willemet-remy/minidisk_automation/Document/20280826_Manuscript minidisk.docx

Experimental paper

Wireless time-of-flight sensor for water level monitoring: Infiltrometer case study

Rémy Willemet1,2*, Maarten Garmyn, Wim M. Cornelis²

¹Plant Sciences Unit, Flanders Research Institute for Agriculture, Fisheries and Food (ILVO), 9090 Merelbeke-Melle, Belgium

²Department of Environment – SENSE Unit, Ghent University, 9000 Ghent, Belgium

³Mississippi Water Resources Research Institute, Mississippi State University, Mississippi State, MS 39762, USA

*Corresponding author: remy.willemet@ilvo.vlaanderen.be

Targeted Journal:

# Abstract

# Introduction

Infiltration is important

Long to take measurements

Dream is costless, wireless, high frequency

3D print, AI helps develop

We can do simple solutions for measurements that

# Material & Method

Components 3D printer

GitHub explanation

Material needed

# Results & Discussion

Cost List + Figure

Part sensor | Cost (per unit) | Units | Provider
Esp 32 mini C3 | | 9
Vl53l4cd | | 8
TP4056 (Battery Chargin module) | | 8
Lipo battery | | 8
Battery holder plastic case | | 8
Buzzer | | 8
Switch/Button | | 16
O-ring rubber
Stainless screw M2

Part infiltrometer
PETG filament | | 1
Acrylic Tubes 26mm ID 32mm OD | | 8
Acrylic Tubes
Valve 32 mm
Stainless + Rubber | | | Meter group
O-ring rubber
Waterproof glue (Parabond) | 13.13 | 1
Stainless 5mm OD 4mm ID

Frequency

Connectivity

Esp32 takes a large place in automation as it’s a cost-effective, high-frequency device with its own communication system and sensors.

Conductivity

Outcomes for every water level device

# Conclusion
