willemet-remy/minidisk_automation/Data sheets/Screenshot 2026-02-20 092105.png

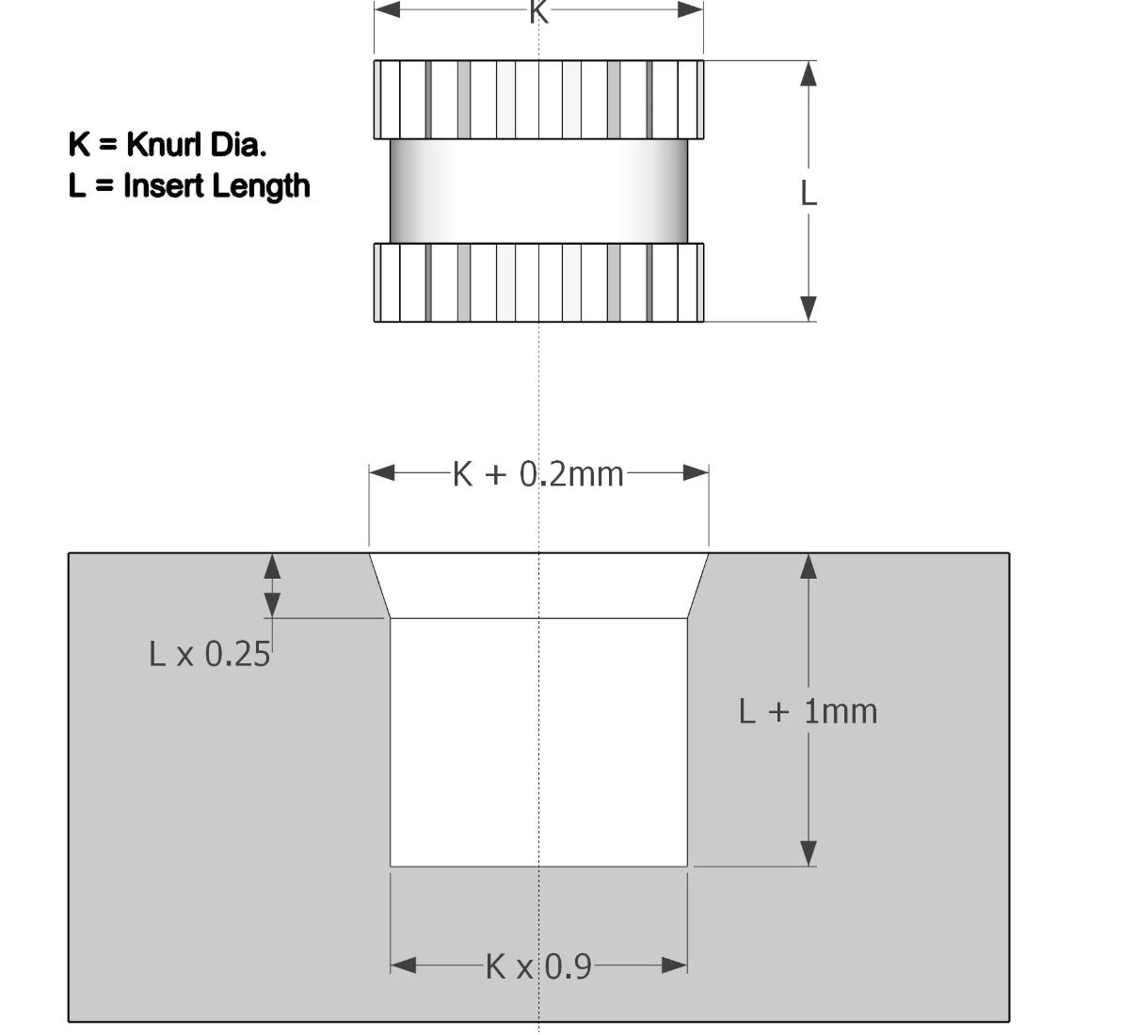
Data sheets/Screenshot 2026-02-20 092105.png
