willemet-remy/minidisk_automation/Figures/IMG_9297.jpg

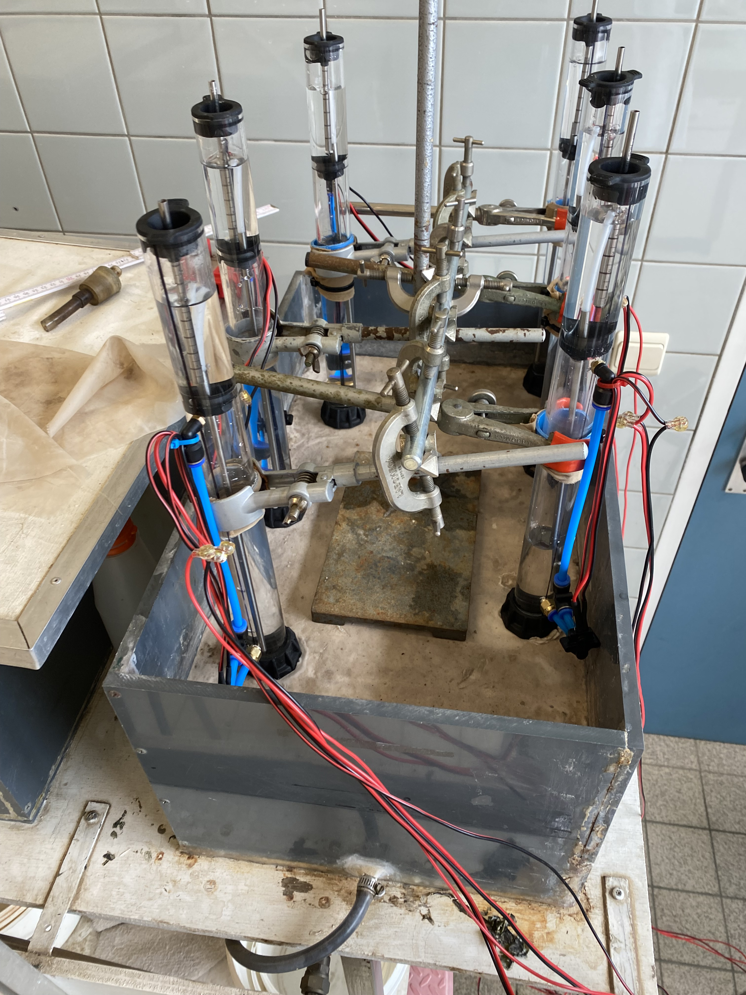
Figures/IMG_9297.jpg
