willemet-remy/minidisk_automation/Figures/IMG_9298.jpg

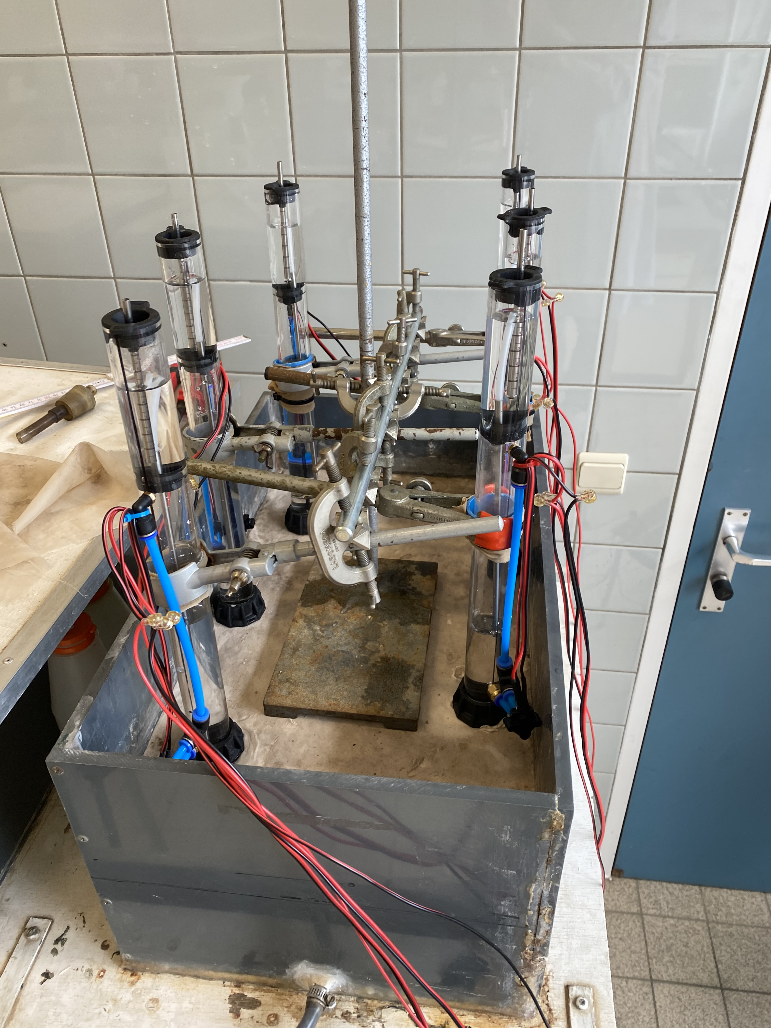
Figures/IMG_9298.jpg
