willemet-remy/minidisk_automation/Figures/IMG_9366.jpg

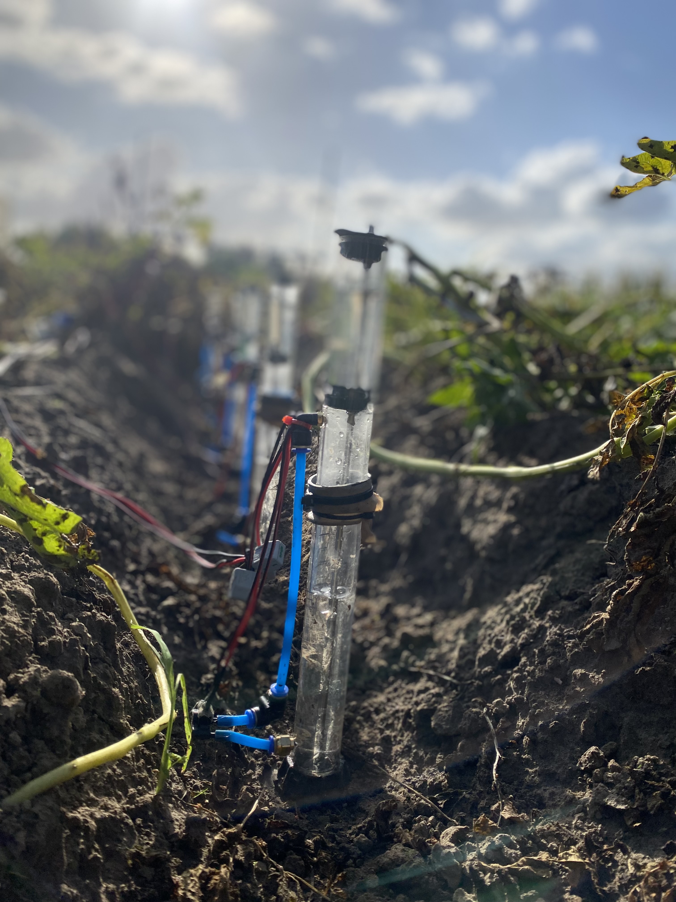
Figures/IMG_9366.jpg
