willemet-remy/minidisk_automation/Figures/IMG_9367.jpg

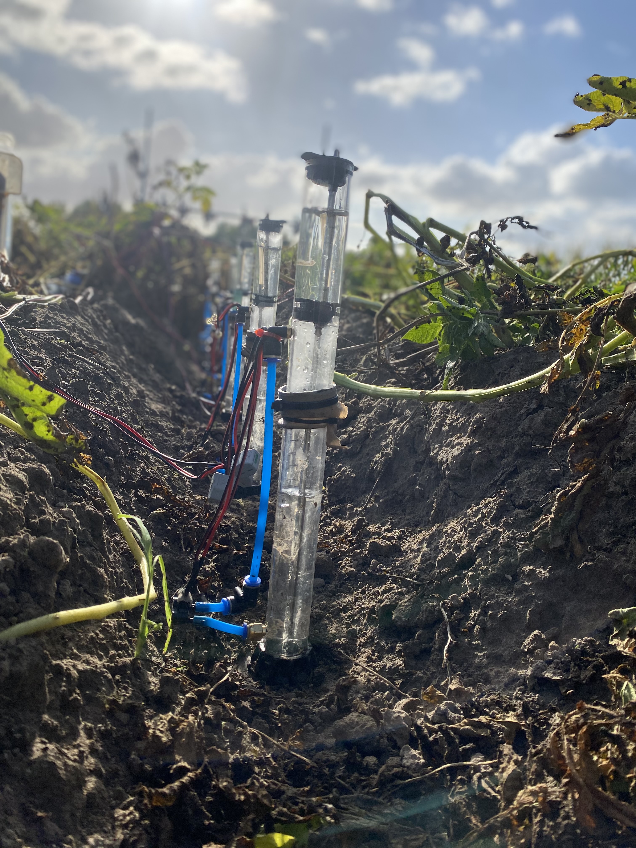
Figures/IMG_9367.jpg
