willemet-remy/minidisk_automation/Figures/IMG_9368.jpg

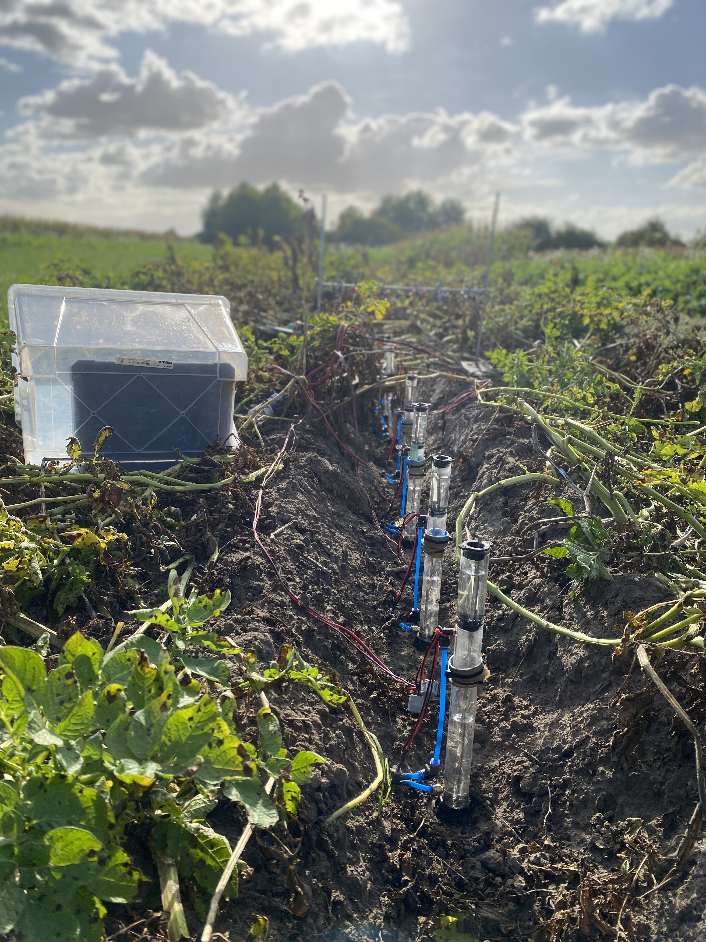
Figures/IMG_9368.jpg
