willemet-remy/minidisk_automation/Figures/IMG_9370.jpg

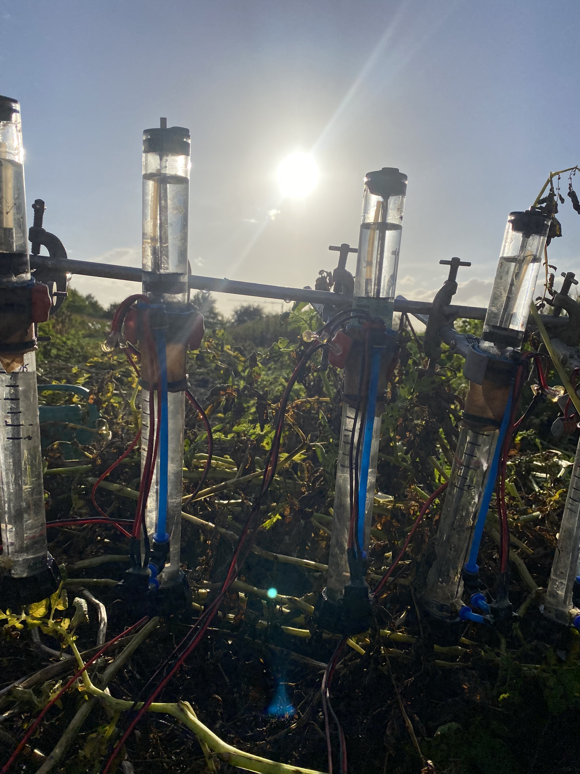
Figures/IMG_9370.jpg
