willemet-remy/minidisk_automation/Figures/IMG_9520.jpg

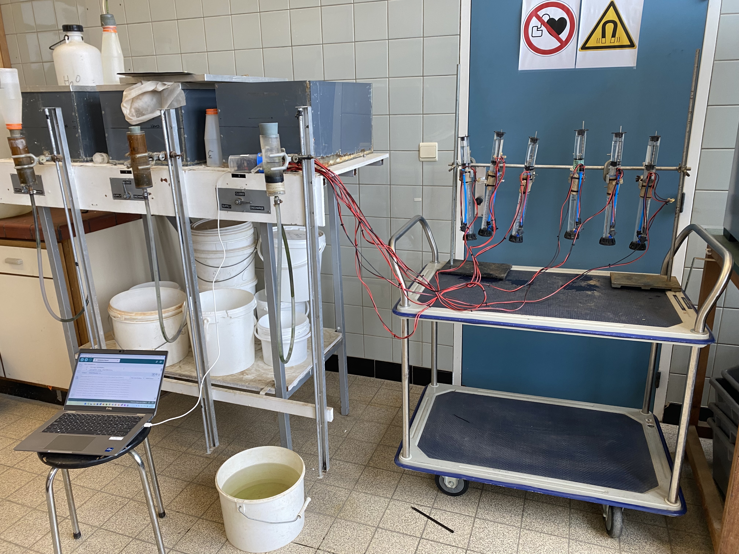
Figures/IMG_9520.jpg
