willemet-remy/minidisk_automation/Figures/IMG_9521.jpg

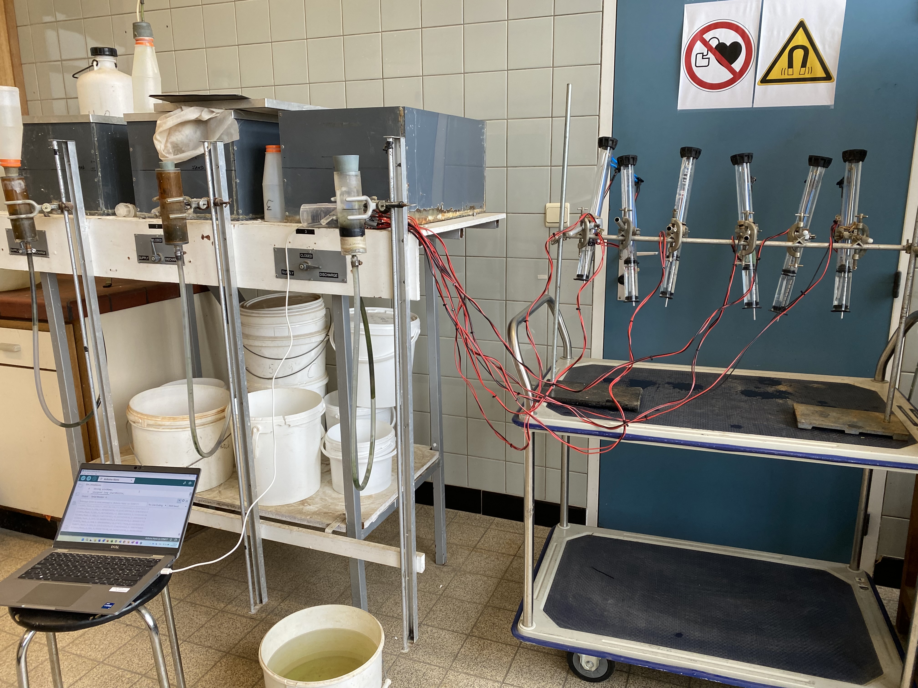
Figures/IMG_9521.jpg
