willemet-remy/minidisk_automation/Figures/IMG_9550.jpg

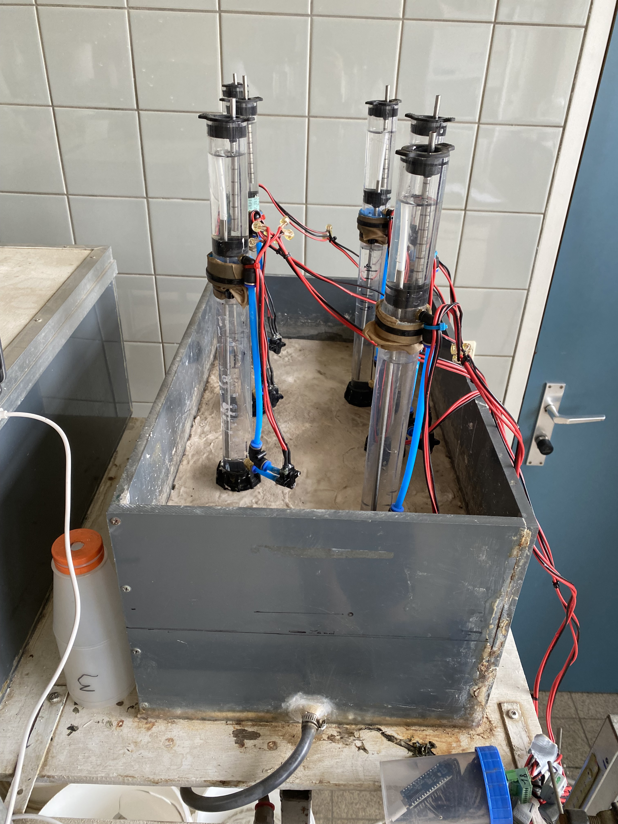
Figures/IMG_9550.jpg
