willemet-remy/minidisk_automation/Figures/IMG_9551.jpg

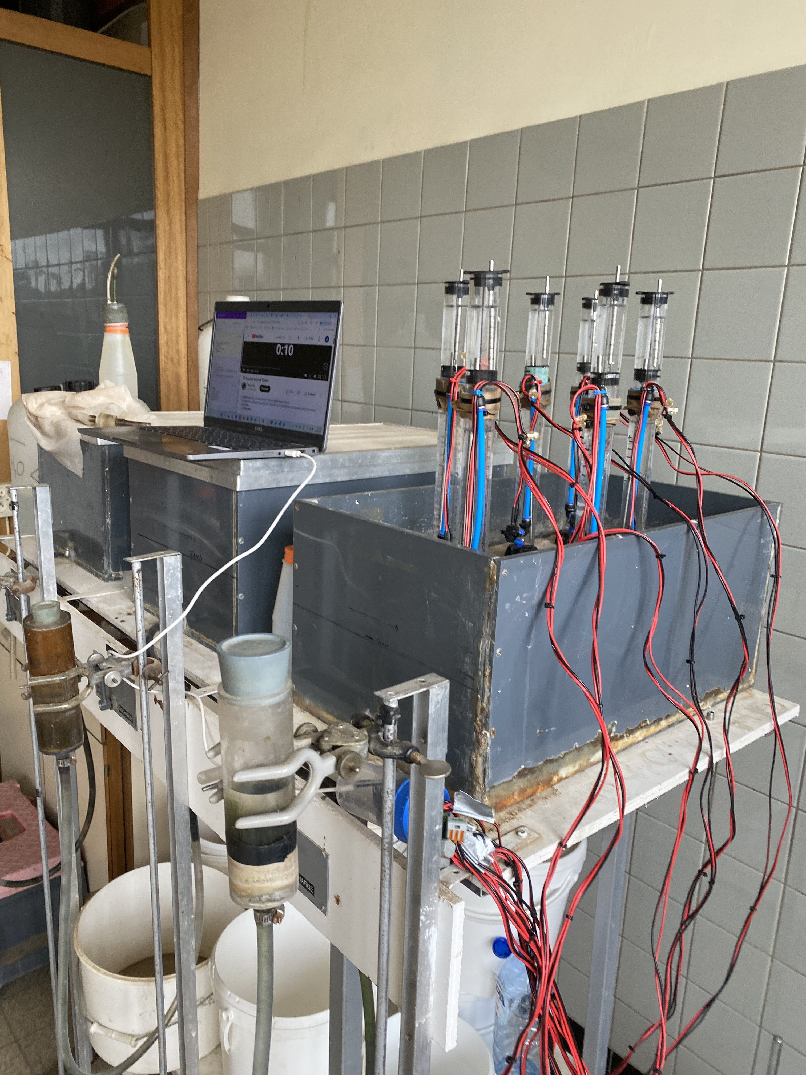
Figures/IMG_9551.jpg
