willemet-remy/minidisk_automation/Figures/Mariotte_Cylinder.gif

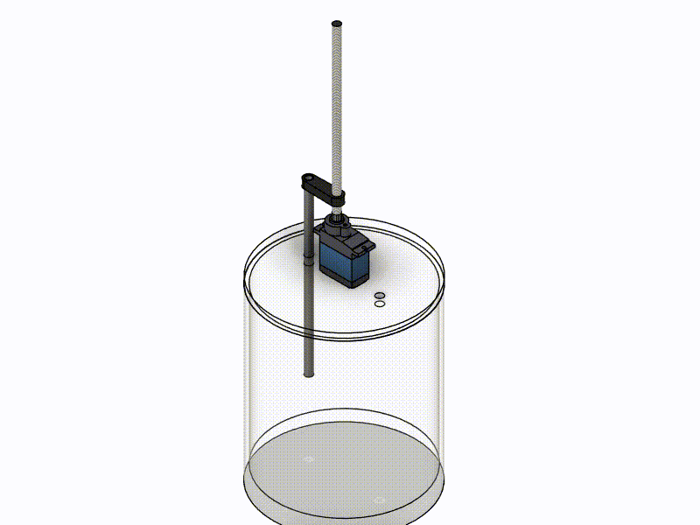
Figures/Mariotte_Cylinder.gif
