willemet-remy/minidisk_automation/PCB_microcontroller/Slimme_minidisk_BOM.xlsx

Component | Designation | Footprint | P/P | Minimal P order | Nbr piece necessary (10) | Piece ordered | Total | Fabrikan nummer | Link
Resistor - 10Kohm | R4,R5,R6,R7 | Resistor_SMD:R_0805_2012Metric_Pad1.20x1.40mm_HandSolder | 0.066 | 100 | 40.00 | 100.00 | 6.60 | ERJHP6F1002V | https://benl.rs-online.com/web/p/surface-mount-resistors/2284960
Resistor 2.7Kohm | R3 | Resistor_SMD:R_0805_2012Metric_Pad1.20x1.40mm_HandSolder | 0.072 | 10 | 10.00 | 10.00 | 0.72 | RT0805BRD072K7L | https://benl.rs-online.com/web/p/surface-mount-resistors/1985630
Resistor - 100ohm | R1,R2 | Resistor_SMD:R_0805_2012Metric_Pad1.20x1.40mm_HandSolder | 0.066 | 100 | 20 | 100 | 6.60 | ERJHP6F1000V | https://benl.rs-online.com/web/p/surface-mount-resistors/2284956
Led - Green | D1 | LED_SMD:LED_0805_2012Metric_Pad1.15x1.40mm_HandSolder | 0.451 | 10 | 10 | 10 | 4.51 | KP-2012MGC | https://benl.rs-online.com/web/p/leds/4663778
Led -Red | D2 | LED_SMD:LED_0805_2012Metric_Pad1.15x1.40mm_HandSolder | 0.224 | 20 | 10 | 20 | 4.48 | KP-2012SYC | https://benl.rs-online.com/web/p/leds/4663835
Cable - 6 brins |  |  | 1.318 |  |  | 25 | 32.95 | 201-2215 | https://benl.rs-online.com/web/p/twisted-pair-multicore-data-cable/2012215
VL53L4CD | U1 | Sensor_Distance:ST_VL53L1x | 3.04 | 1 | 10 | 10 | 30.40 | VL53L4CDV9DH/1 | https://benl.rs-online.com/web/p/proximity-sensor-ics/0215169
MCP23017 |  |  | 1.476 | 5 |  |  |  | MCP23017-E/SP | https://benl.rs-online.com/web/p/io-expanders/0403806
Capacitor - 4.7µF | C1 | Capacitor_SMD:C_0805_2012Metric_Pad1.18x1.45mm_HandSolder | 0.11 | 10 | 10 | 10 | 1.10 | GRT21BR61H475KE13L | https://benl.rs-online.com/web/p/mlccs-multilayer-ceramic-capacitors/2478211
Capacitor - 0.1 µF | C2 | Capacitor_SMD:C_0805_2012Metric_Pad1.18x1.45mm_HandSolder | 0.105 | 100 | 10 | 100 | 10.50 | GCJ21BR72A104KA01K | https://benl.rs-online.com/web/p/mlccs-multilayer-ceramic-capacitors/2608714
BC817W | Q1 | Package_TO_SOT_SMD:SOT-323_SC-70
DevkitC
PCB
Rubber |  |  | 5.99 | 1 | 1 | 1 | 5.99 | 196-5426 | https://benl.rs-online.com/web/p/gaskets-o-rings/1965426
Solder paste |  |  | 14.27 | 1 | 1 | 1 | 14.27 | SMD291AX50T3 | https://benl.rs-online.com/web/p/solder-pastes/1466191
Stepper motor |  |  |  |  |  |  |  |  | https://benl.rs-online.com/web/p/power-motor-robotics-development-tools/1793741
Mesh
