willemet-remy/minidisk_automation/PCB_microcontroller/PCB_sensor_V4/BOM_PCB_V4.csv

Reference | Qty | Value | DNP | Exclude from BOM | Exclude from Board | Footprint | Datasheet
C1 | 1 | 0.1µF |  |  |  | Capacitor_SMD:C_0805_2012Metric_Pad1.18x1.45mm_HandSolder | ~
C2 | 1 | 4.7µF |  |  |  | Capacitor_SMD:C_0805_2012Metric_Pad1.18x1.45mm_HandSolder | ~
D1 | 1 | LED RED |  |  |  | LED_SMD:LED_0805_2012Metric_Pad1.15x1.40mm_HandSolder | ~
D2 | 1 | LED Green |  |  |  | LED_SMD:LED_0805_2012Metric_Pad1.15x1.40mm_HandSolder | ~
H1 | 1 | SCL |  | Excluded from BOM |  | TestPoint:TestPoint_Pad_1.5x1.5mm | ~
H2 | 1 | SDA |  | Excluded from BOM |  | TestPoint:TestPoint_Pad_D1.5mm | ~
H3 | 1 | GPI0 |  | Excluded from BOM |  | TestPoint:TestPoint_Pad_D1.5mm | ~
H4 | 1 | XSHUT |  | Excluded from BOM |  | TestPoint:TestPoint_Pad_D1.5mm | ~
H5 | 1 | 3V3 |  | Excluded from BOM |  | TestPoint:TestPoint_Pad_D1.5mm | ~
H6 | 1 | GND |  | Excluded from BOM |  | TestPoint:TestPoint_Pad_D1.5mm | ~
H7 | 1 | MountingHole_Pad |  | Excluded from BOM |  | Growing_chamber:MountingHole_5mm_modif | ~
Q1 | 1 | BC817W |  |  |  | Package_TO_SOT_SMD:SOT-323_SC-70 | https://www.onsemi.com/pub/Collateral/BC818-D.pdf
R1,R2 | 2 | 100 |  |  |  | Resistor_SMD:R_0805_2012Metric_Pad1.20x1.40mm_HandSolder | ~
R3 | 1 | 2.7K |  |  |  | Resistor_SMD:R_0805_2012Metric_Pad1.20x1.40mm_HandSolder | ~
R4 | 1 | 10KΩ |  |  |  | Resistor_SMD:R_0805_2012Metric_Pad1.20x1.40mm_HandSolder | ~
R5,R6,R7 | 3 | 10K |  |  |  | Resistor_SMD:R_0805_2012Metric_Pad1.20x1.40mm_HandSolder | ~
U1 | 1 | VL53L0CXV0DH1 |  |  |  | Sensor_Distance:ST_VL53L1x | https://www.st.com/resource/en/datasheet/vl53l0x.pdf
