willemet-remy/minidisk_automation/Model/3D_print/case_nodemcu_esp32_s_sma_antenna_mount_bottom.3mf

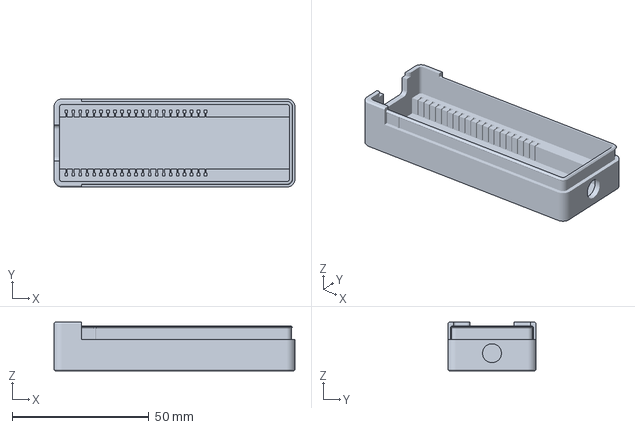
[picture p23: CAD file, 2026-10-27]
Model/3D_print/case_nodemcu_esp32_s_sma_antenna_mount_bottom.3mf
88.0 x 32.2 x 17.8 mm
