willemet-remy/minidisk_automation/Model/Fusion360/CapV3.3mf

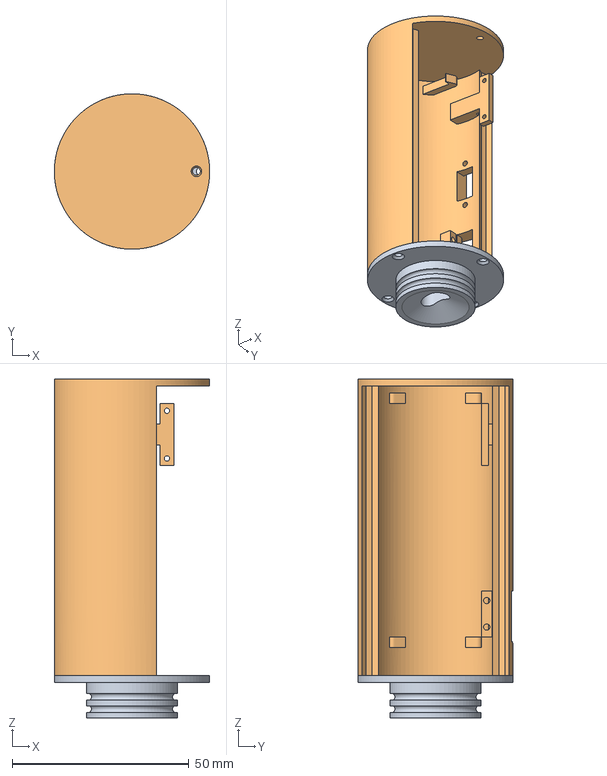
[picture p24: CAD file, 2026-09-15]
Model/Fusion360/CapV3.3mf
44.0 x 44.0 x 96.0 mm
