willemet-remy/minidisk_automation/Model/3D_print/case_nodemcu_esp32_s_sma_antenna_mount_top.3mf

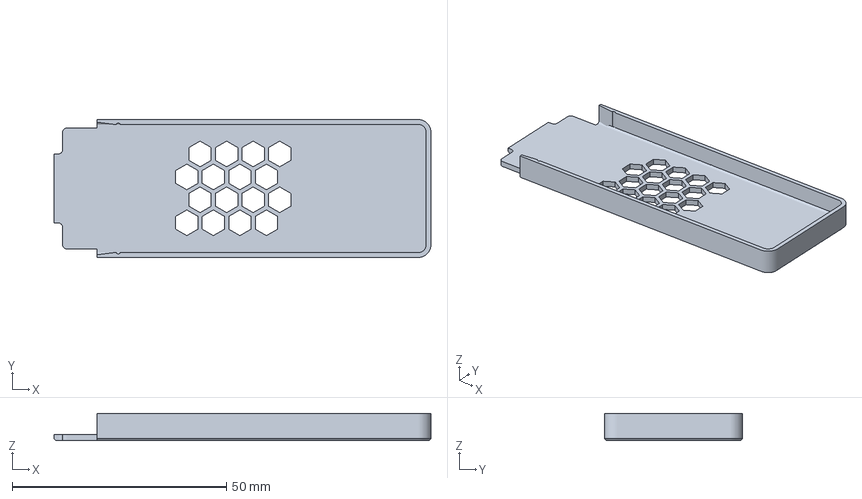
[picture p25: CAD file, 2026-10-27]
Model/3D_print/case_nodemcu_esp32_s_sma_antenna_mount_top.3mf
88.0 x 32.2 x 6.40 mm
