willemet-remy/minidisk_automation/Model/3D_print/Joint_tubes.stl

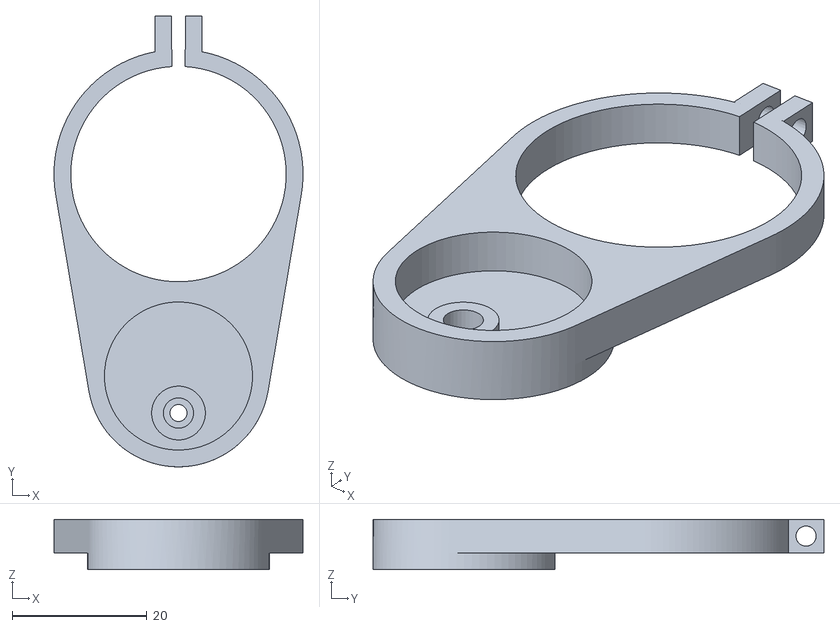
[picture p26: CAD file, 2026-09-15]
Model/3D_print/Joint_tubes.stl
37.0 x 67.0 x 7.50
