willemet-remy/minidisk_automation/Model/Fusion360/External_components/ss12d10.stp

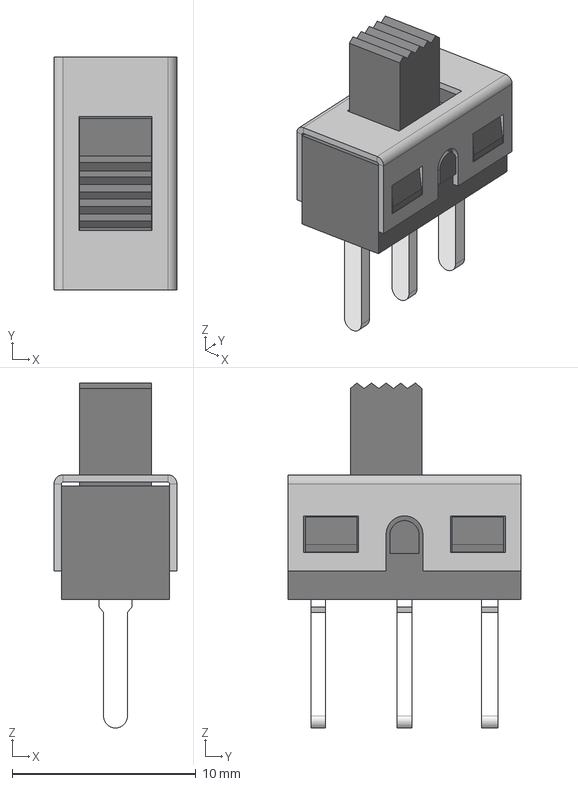
[picture p27: CAD file, 2026-09-15]
Model/Fusion360/External_components/ss12d10.stp
6.70 x 12.7 x 18.8 mm
