willemet-remy/minidisk_automation/Model/3D_print/Cap_bottom.stl

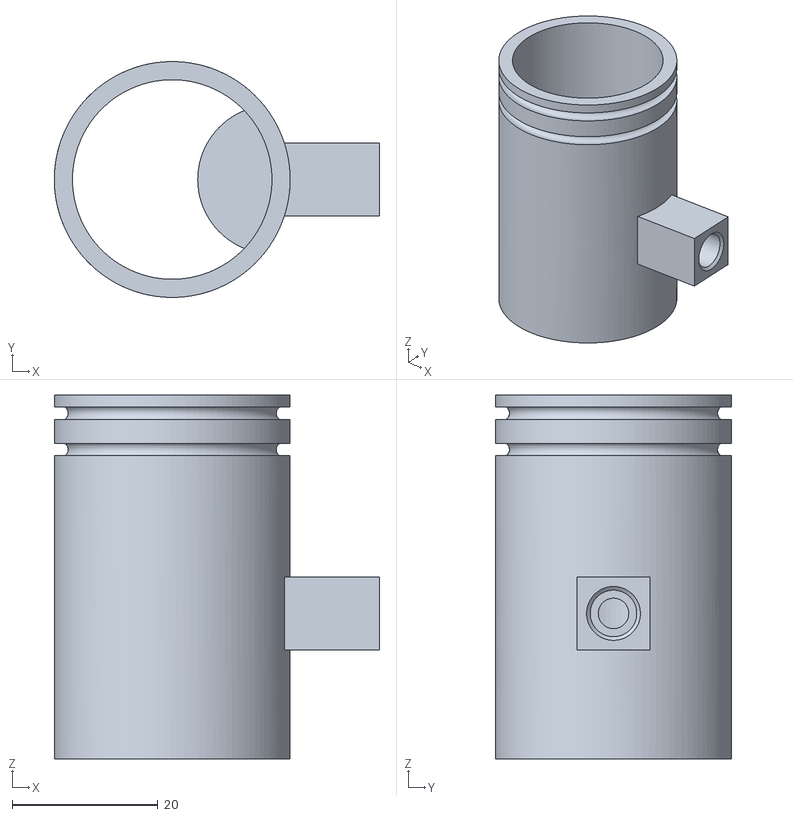
[picture p28: CAD file, 2026-09-15]
Model/3D_print/Cap_bottom.stl
44.7 x 32.4 x 50.0
