willemet-remy/minidisk_automation/Model/Fusion360/External_components/Esp32-C3_mini.STEP

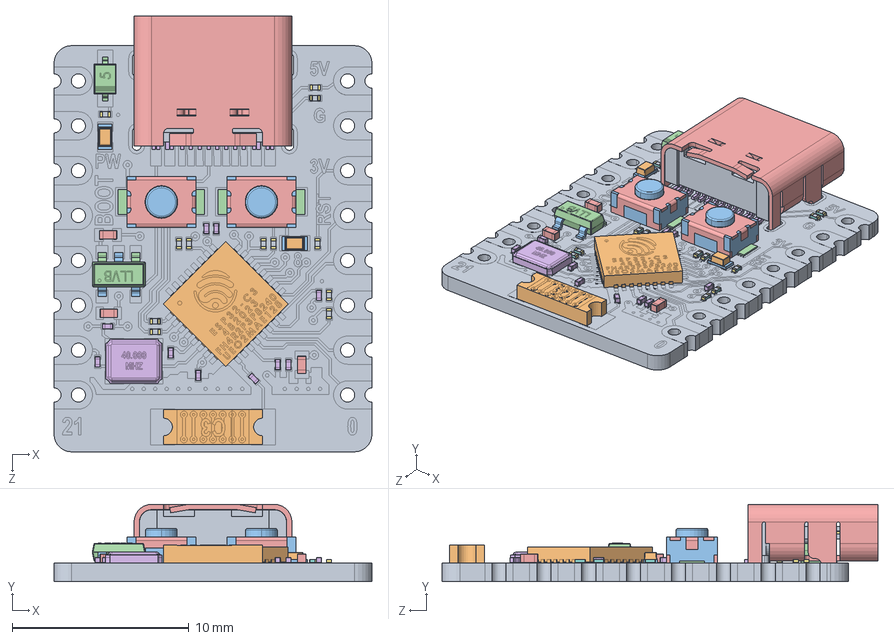
[picture p29: CAD file, 2026-09-15]
Model/Fusion360/External_components/Esp32-C3_mini.STEP
18.0 x 4.38 x 24.7 mm
PIEZASLDPRT
ESP82C3
LLVB
C0402 x 3
C0201 x 10
R0201 x 12
Led 0603 Smd x 2
SOD323 5
USB C female
Antenna_C3
SMD Micro Switch 3x4x2mm x 2
SMD Quartz Crystal 3.2x2.5mm
