willemet-remy/minidisk_automation/Model/3D_print/Cap_top_body1.stl

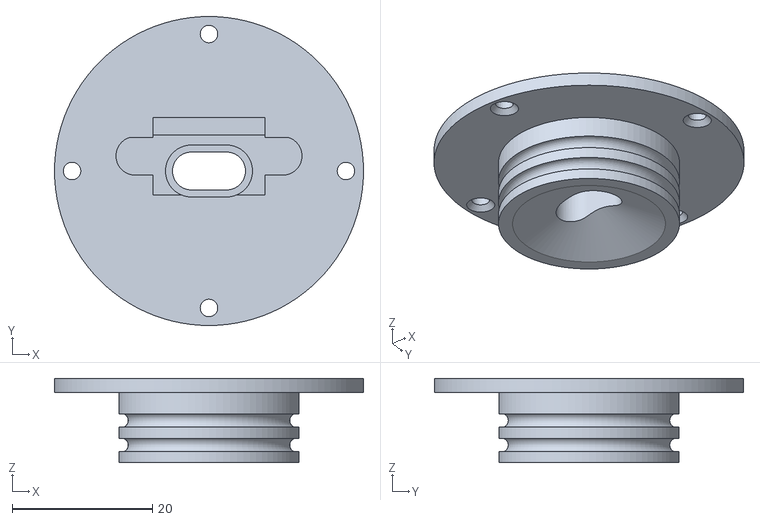
[picture p30: CAD file, 2026-09-10]
Model/3D_print/Cap_top_body1.stl
44.0 x 44.0 x 12.0
