willemet-remy/minidisk_automation/Model/Fusion360/External_components/Mini Slide Switch.step

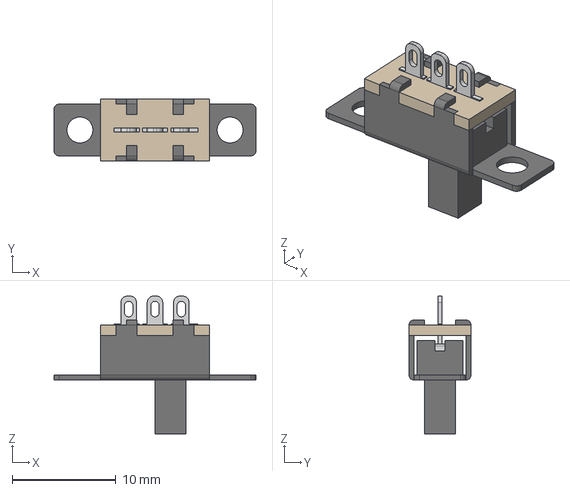
[picture p31: CAD file, 2026-09-15]
Model/Fusion360/External_components/Mini Slide Switch.step
19.5 x 6.00 x 13.3 mm
