willemet-remy/minidisk_automation/Model/3D_print/Cap_top_body2.stl

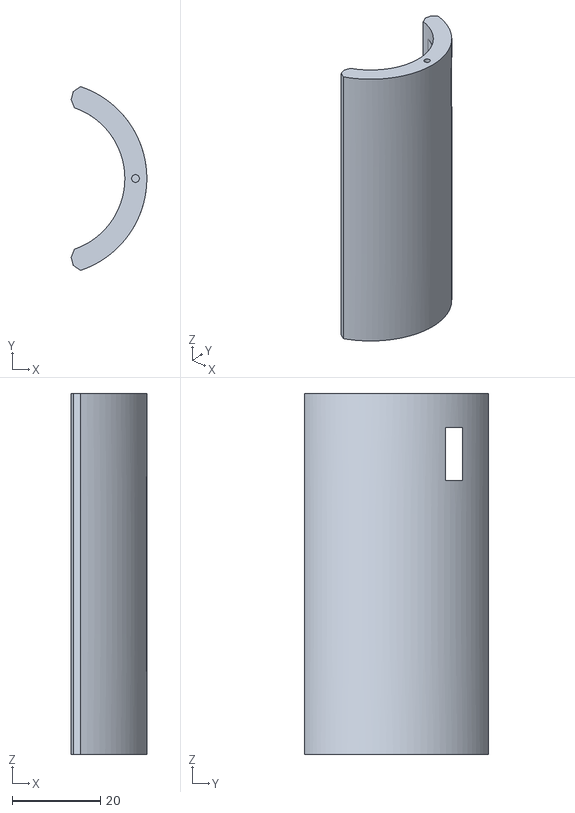
[picture p32: CAD file, 2026-09-10]
Model/3D_print/Cap_top_body2.stl
17.2 x 41.8 x 82.0
