willemet-remy/minidisk_automation/Model/Fusion360/External_components/Acrylic_Tube_small.stl

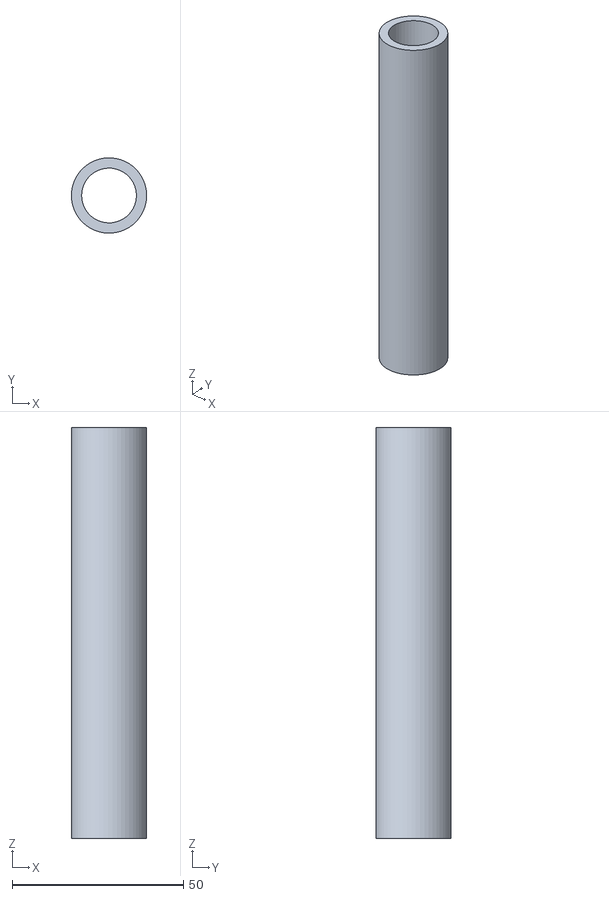
[picture p33: CAD file, 2026-09-15]
Model/Fusion360/External_components/Acrylic_Tube_small.stl
22.0 x 22.0 x 120.0
