willemet-remy/minidisk_automation/Model/Fusion360/External_components/MicroSwitch 2A SPDT CYT1073 3D.stl

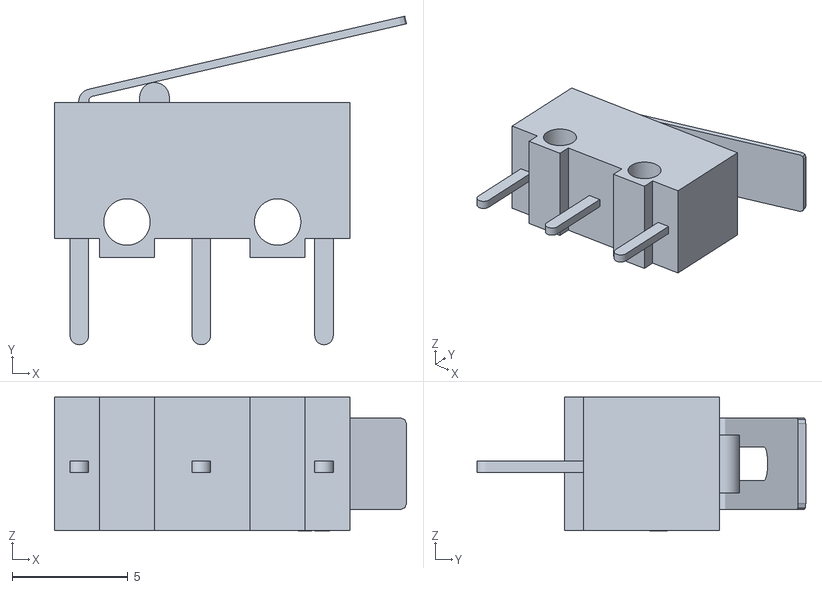
[picture p35: CAD file, 2026-09-15]
Model/Fusion360/External_components/MicroSwitch 2A SPDT CYT1073 3D.stl
15.2 x 14.2 x 5.77
