willemet-remy/minidisk_automation/Model/Fusion360/External_components/TP4056_Charging_Module_Type_C.step

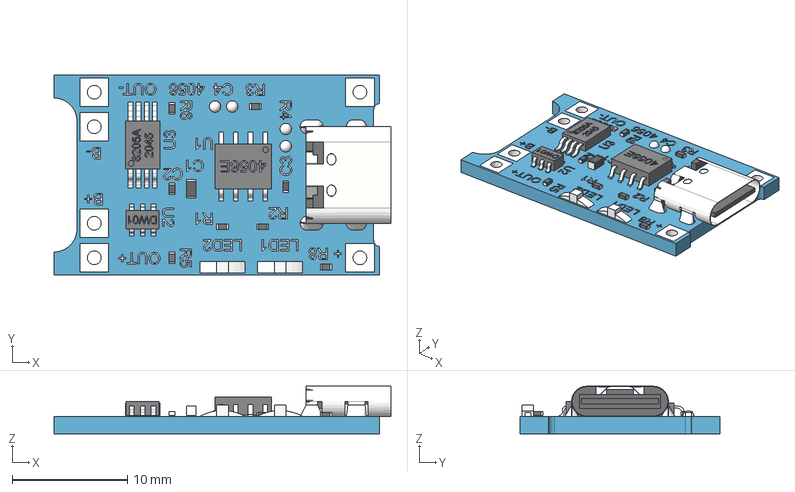
[picture p36: CAD file, 2026-09-15]
Model/Fusion360/External_components/TP4056_Charging_Module_Type_C.step
29.3 x 17.4 x 4.14 mm
board
USB_Type_C_Connector
8205A_2045
DW01-P
small1005_smd_resistor x 2
small1005_smd_resistor (1)
small1005_smd_capacitor
smd_capacitor
SOP-8_4056E
solder_dot_round
solder_dot_round (1)
solder_dot_round (2)
solder_dot_round (3)
small1005_smd_capacitor (1)
LED2
LED2 (1)
small1005_smd_resistor (2)
small1005_smd_resistor (4) x 2
soldering
