willemet-remy/minidisk_automation/Model/Fusion360/External_components/Acrylic Tube.stl

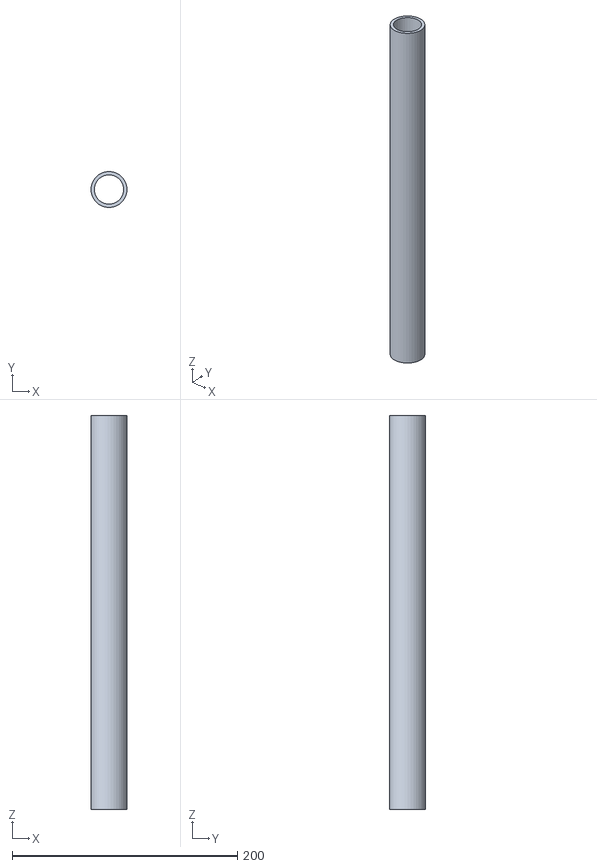
[picture p37: CAD file, 2026-09-15]
Model/Fusion360/External_components/Acrylic Tube.stl
32.0 x 31.9 x 350.0
