willemet-remy/minidisk_automation/Model/Fusion360/External_components/AH14629-A.stp

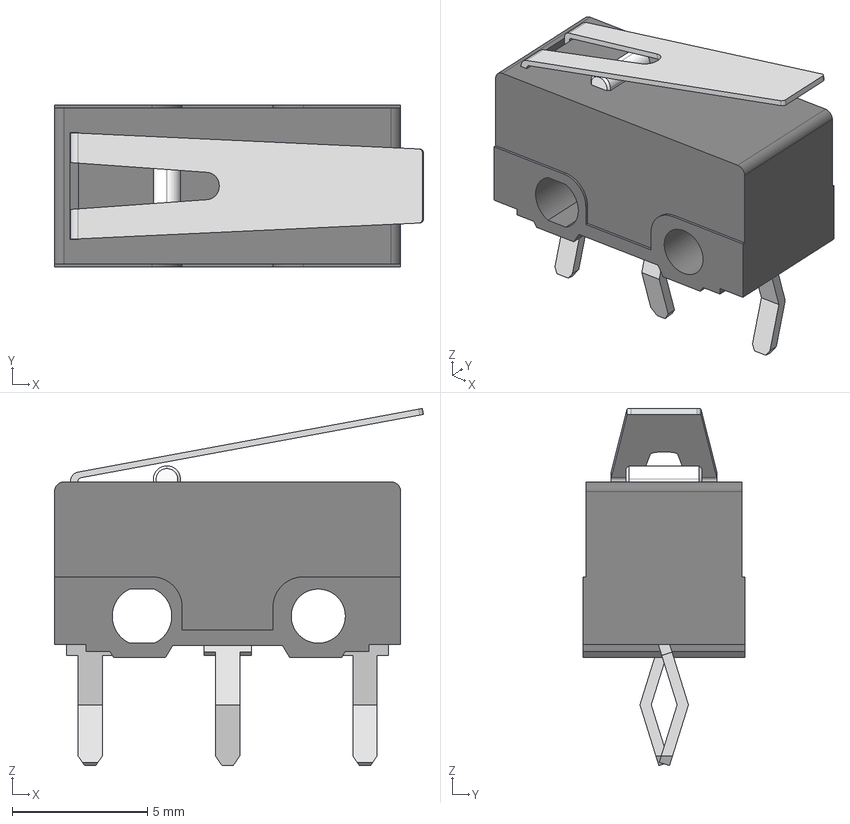
[picture p39: CAD file, 2026-09-15]
Model/Fusion360/External_components/AH14629-A.stp
13.6 x 6.00 x 13.2 mm
