willemet-remy/minidisk_automation/Model/Fusion360/External_components/18650 3.7V Battery Box Case with On Off Switch.STEP

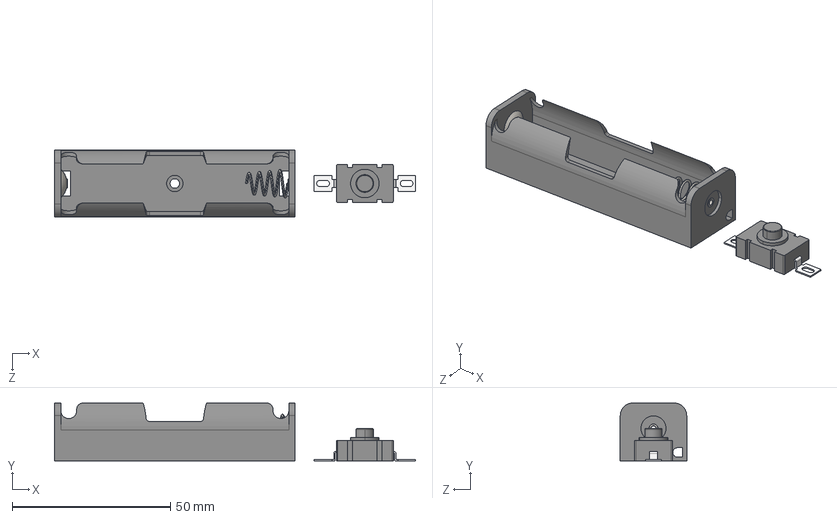
[picture p40: CAD file, 2026-09-15]
Model/Fusion360/External_components/18650 3.7V Battery Box Case with On Off Switch.STEP
114.0 x 18.3 x 21.0 mm
Case, 18650 3.7V Battery Box Case with On Off Switch
Battery Conduction Clip, Positive Terminal, 18650 3.7V Battery Box Case with On Off Switch
Battery Conduction Rivet, Negative Terminal, 18650 3.7V Battery Box Case with On Off Switch
Spring, 18650 3.7V Battery Box Case with On Off Switch
Push Button, 18650 3.7V Battery Box Case with On Off Switch
