willemet-remy/minidisk_automation/(list of files, cad)

Other CAD files:
Model/Fusion360/CapV3.f3d
Model/Fusion360/External_components/2772T93_NO THREADS_Straight Plastic On-Off Valve.stl
