willemet-remy/minidisk_automation/Figures/Sensor V2 Drawing.pdf

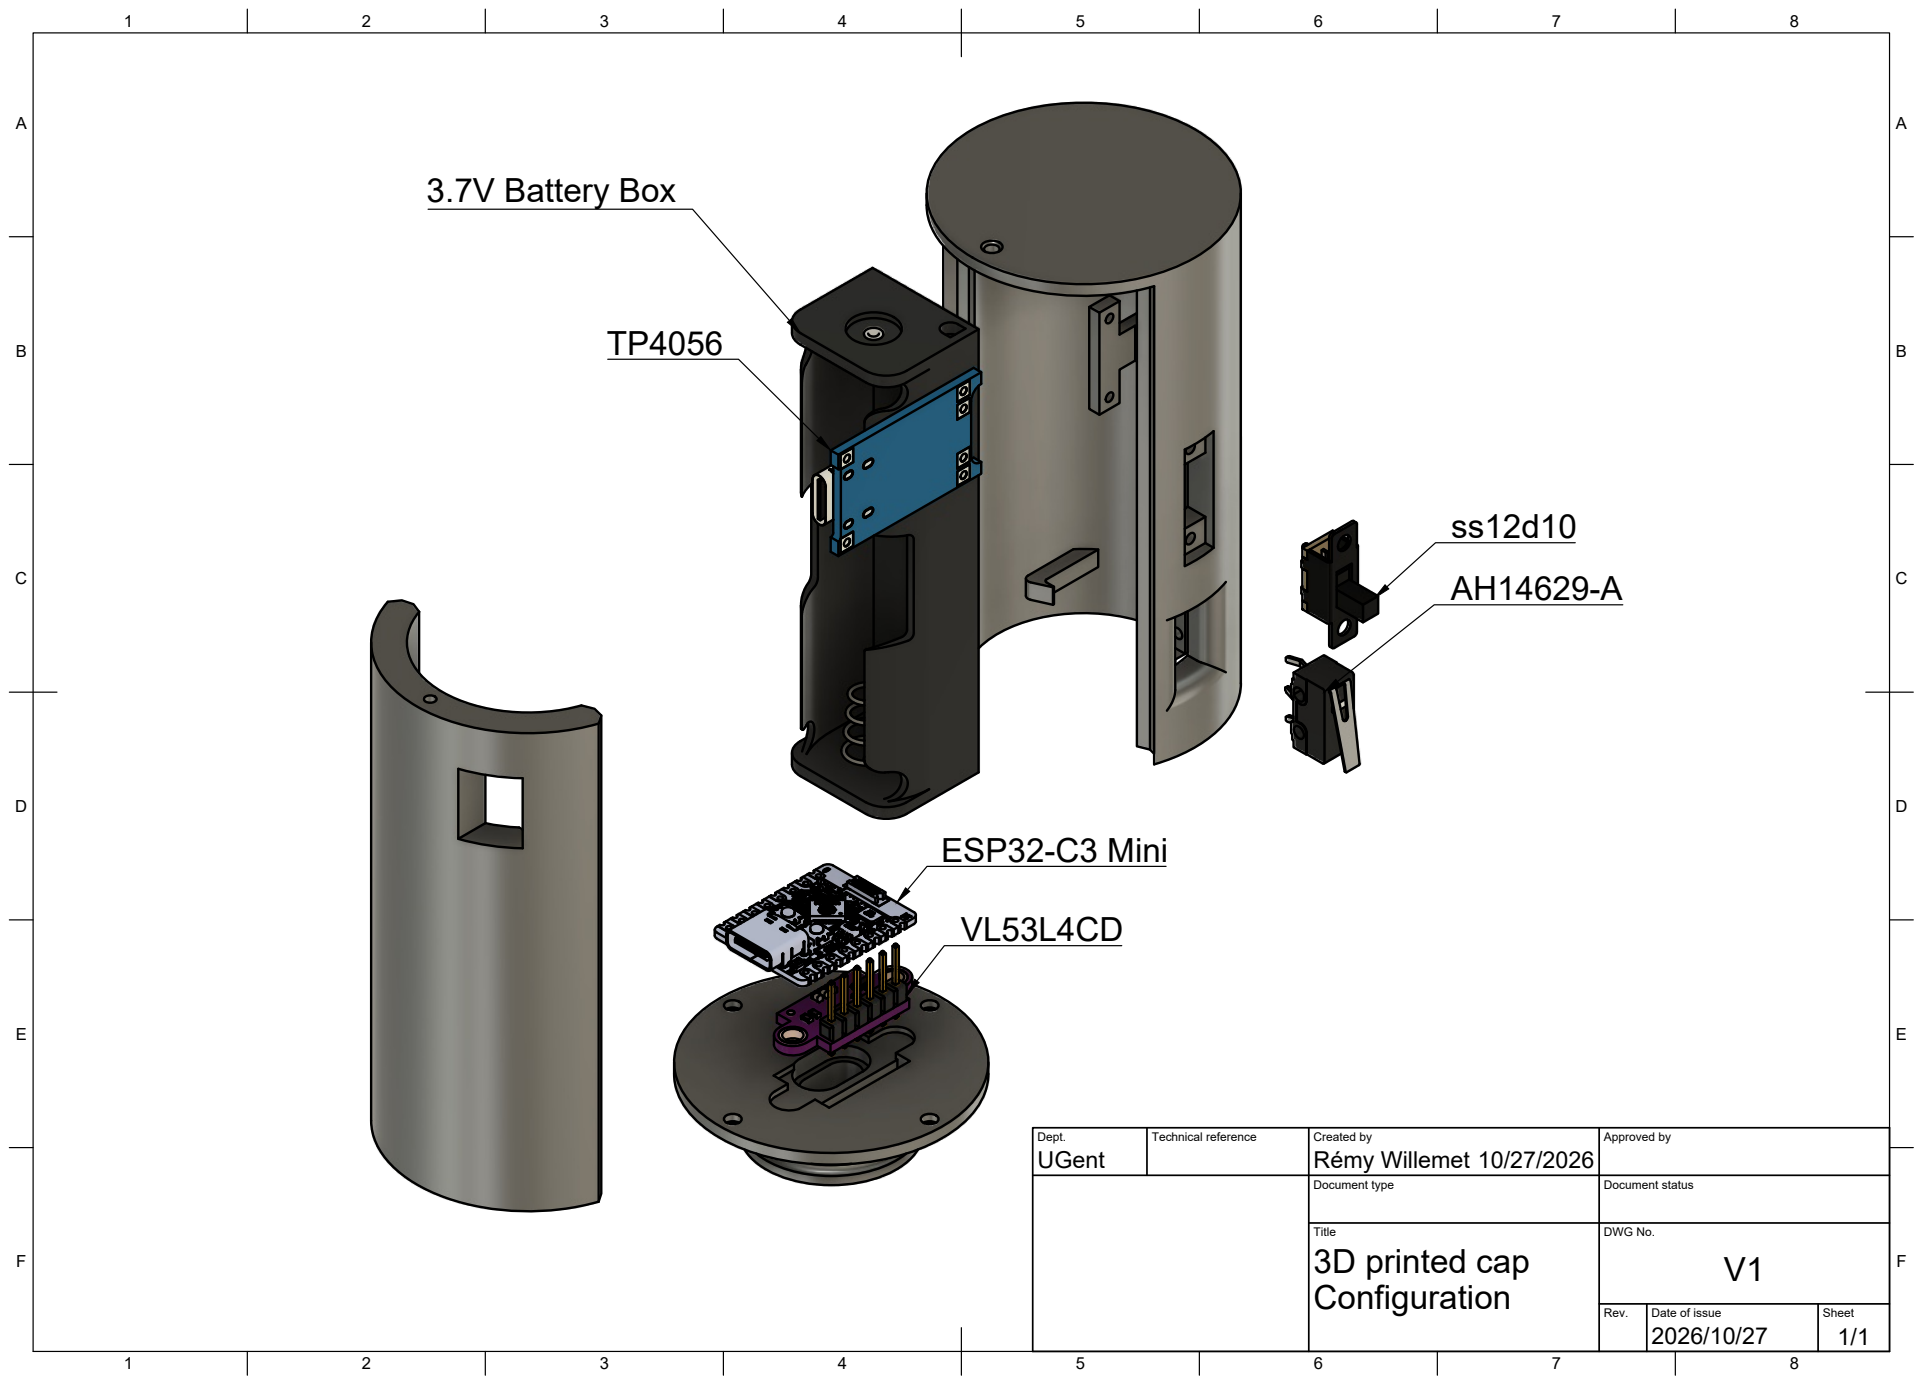
[picture p41: page 1]
Title; DWG No.; Rev.; Date of issue; Sheet; 3D printed cap; 3.7V Battery Box; ESP32-C3 Mini

Dept. UGent | Technical reference | Created by Rémy Willemet 10/27/2026 | Approved by

Document type | Document status
