willemet-remy/minidisk_automation/Figures/Slimme_minidisk_V1.pdf

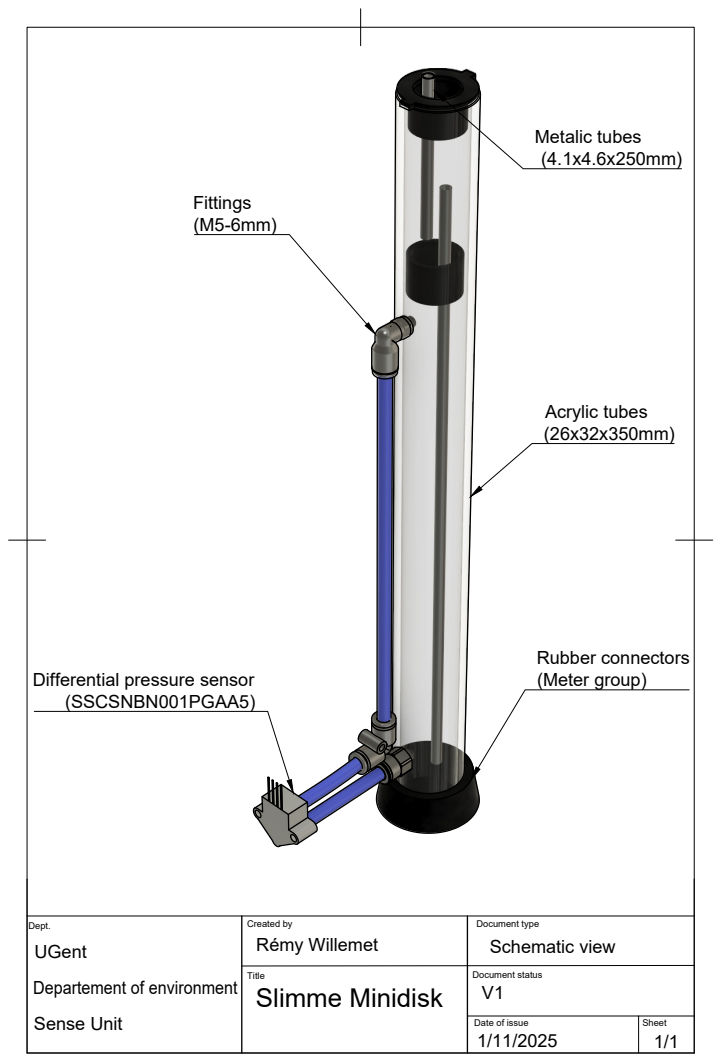
[picture p42: page 1]
Acrylic tubes; Metalic tubes; Rubber connectors; Differential pressure sensor; (Meter group)

Dept. UGent Departement of environment Sense Unit | Created by Rémy Willemet | Document type Schematic view

Title Slimme Minidisk | Document status V1

Date of issue 1/11/2025 | Sheet 1/1
