willemet-remy/minidisk_automation/PCB_microcontroller/PCB_sensor_V2/PCB_sensor.kicad_pcb

## KiCad design PCB_microcontroller/PCB_sensor_V2/PCB_sensor.kicad_pcb (2026-03-01, an earlier design)

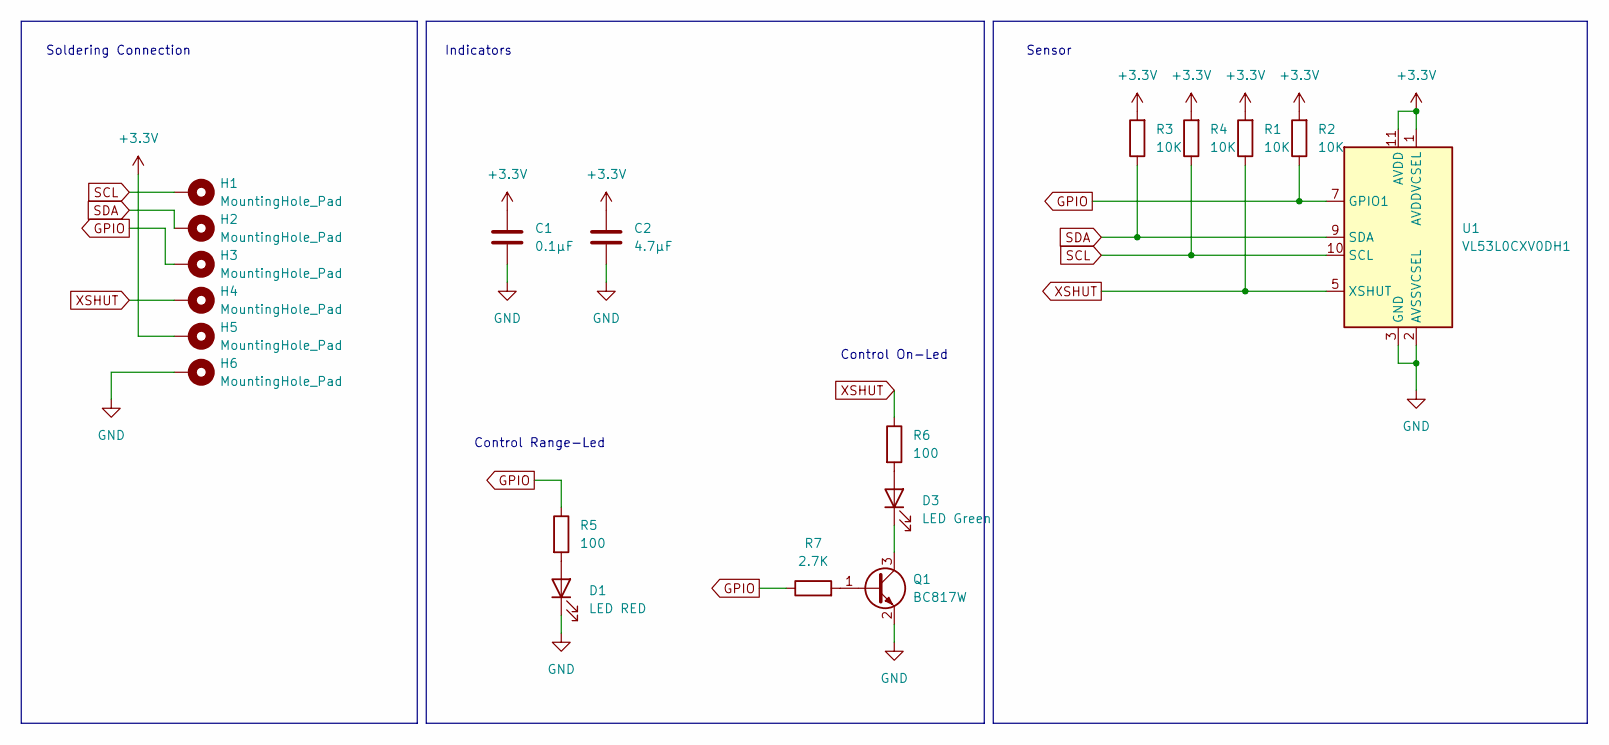
[picture p43: schematic PCB_sensor.kicad_sch]

Parts:
C1: 0.1µF; C_0201_0603Metric_Pad0.64x0.40mm_HandSolder
C2: 4.7µF; C_0201_0603Metric_Pad0.64x0.40mm_HandSolder
D1: LED RED; LED_0201_0603Metric_Pad0.64x0.40mm_HandSolder
D3: LED Green; LED_0201_0603Metric_Pad0.64x0.40mm_HandSolder
H1: MountingHole_Pad; TestPoint_Pad_1.5x1.5mm
H2, H3, H4, H5, H6: MountingHole_Pad; TestPoint_Pad_D1.5mm
Q1: BC817W; SOT-323_SC-70
R1, R2, R3, R4: 10K; R_0201_0603Metric_Pad0.64x0.40mm_HandSolder
R5, R6: 100; R_0201_0603Metric_Pad0.64x0.40mm_HandSolder
R7: 2.7K; R_0201_0603Metric_Pad0.64x0.40mm_HandSolder
U1: VL53L0CXV0DH1; ST_VL53L1x

Connections:
+3.3V: C1.1, C2.1, H5.1, R1.2, R2.2, R3.2, R4.2, U1.1 (AVDDVCSEL), U1.11 (AVDD)
GND: C1.2, C2.2, D1.1 (K), H6.1, Q1.2 (E), U1.2 (AVSSVCSEL), U1.3 (GND), U1.4 (GND), U1.6 (GND), U1.12 (GND)
GPIO: H3.1, R2.1, R5.1, R7.1, U1.7 (GPIO1)
unnamed: D1.2 (A), R5.2
unnamed: D3.2 (A), R6.2
unnamed: D3.1 (K), Q1.3 (C)
unnamed: Q1.1 (B), R7.2
SCL: H1.1, R4.1, U1.10 (SCL)
SDA: H2.1, R3.1, U1.9 (SDA)
XSHUT: H4.1, R1.1, R6.1, U1.5 (XSHUT)

Notes on the sheet:
Indicators
Control On-Led
Sensor
Soldering Connection
Control Range-Led

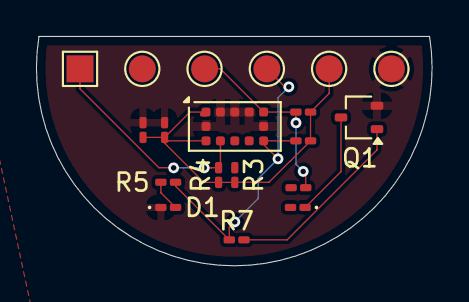
[picture p44: board PCB_microcontroller/PCB_sensor_V2/PCB_sensor.kicad_pcb from above]

Board: 2 copper layers, 22.0 x 12.7 mm, 19 parts (0 on the bottom side), 10 nets.
