willemet-remy/minidisk_automation/PCB_microcontroller/PCB_sensor_V4/PCB_sensor.kicad_pcb

## KiCad design PCB_microcontroller/PCB_sensor_V4/PCB_sensor.kicad_pcb (2026-03-01)

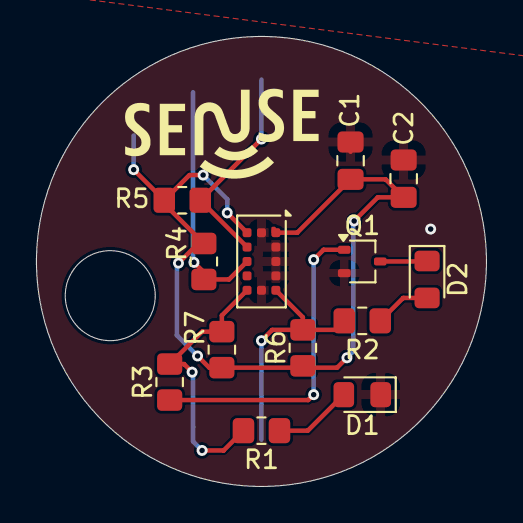
[picture p45: board PCB_microcontroller/PCB_sensor_V4/PCB_sensor.kicad_pcb from above]

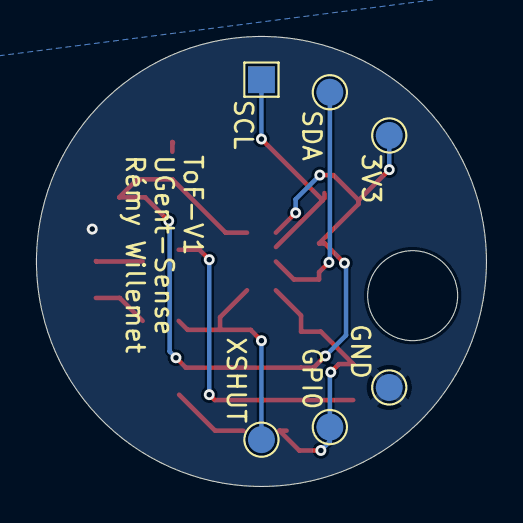
[picture p46: board PCB_microcontroller/PCB_sensor_V4/PCB_sensor.kicad_pcb from below]

Board: 2 copper layers, 25.0 x 25.0 mm, 20 parts (6 on the bottom side), 10 nets.

Parts:
C1: 0.1µF; C_0805_2012Metric_Pad1.18x1.45mm_HandSolder
C2: 4.7µF; C_0805_2012Metric_Pad1.18x1.45mm_HandSolder
D1: LED RED; LED_0805_2012Metric_Pad1.15x1.40mm_HandSolder
D2: LED Green; LED_0805_2012Metric_Pad1.15x1.40mm_HandSolder
GND: GND; TestPoint_Pad_D1.5mm
H1: SCL; TestPoint_Pad_1.5x1.5mm
H2: SDA; TestPoint_Pad_D1.5mm
H3: GPI0; TestPoint_Pad_D1.5mm
H4: XSHUT; TestPoint_Pad_D1.5mm
H5: 3V3; TestPoint_Pad_D1.5mm
H7: MountingHole_Pad; MountingHole_5mm_modif
Q1: BC817W; SOT-323_SC-70
R1, R2: 100; R_0805_2012Metric_Pad1.20x1.40mm_HandSolder
R3: 2.7K; R_0805_2012Metric_Pad1.20x1.40mm_HandSolder
R4: 10KΩ; R_0805_2012Metric_Pad1.20x1.40mm_HandSolder
R5, R6, R7: 10K; R_0805_2012Metric_Pad1.20x1.40mm_HandSolder
U1: VL53L0CXV0DH1; ST_VL53L1x

Connections:
+3.3V: C1.1, C2.1, H5.1, R4.2, R5.2, R6.2, R7.2, U1.1 (AVDDVCSEL), U1.11 (AVDD)
GND: C1.2, C2.2, D1.1 (K), GND.1, Q1.2 (E), U1.2 (AVSSVCSEL), U1.3 (GND), U1.4 (GND), U1.6 (GND), U1.12 (GND)
GPIO: H3.1, R1.1, R3.1, R7.1, U1.7 (GPIO1)
unnamed: D1.2 (A), R1.2
unnamed: D2.2 (A), R2.2
unnamed: D2.1 (K), Q1.3 (C)
unnamed: Q1.1 (B), R3.2
SCL: H1.1, R5.1, U1.10 (SCL)
SDA: H2.1, R4.1, U1.9 (SDA)
XSHUT: H4.1, R2.1, R6.1, U1.5 (XSHUT)
