willemet-remy/minidisk_automation/PCB_microcontroller/PCB_sensor_V1/PCB_sensor.kicad_pcb

## KiCad design PCB_microcontroller/PCB_sensor_V1/PCB_sensor.kicad_pcb (2026-03-01, an earlier design)

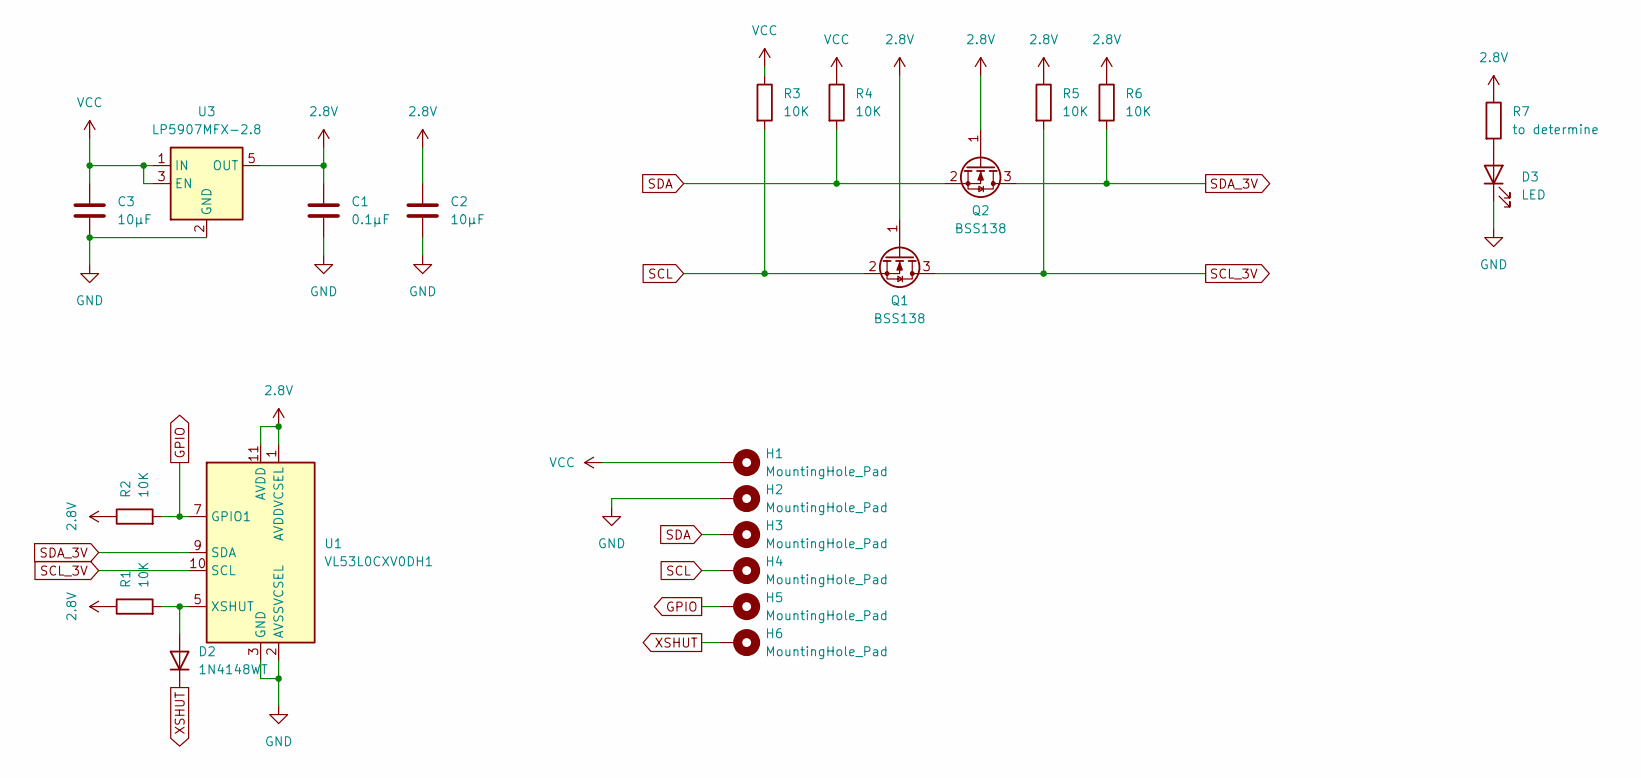
[picture p47: schematic PCB_sensor.kicad_sch]

Parts:
C1: 0.1µF; C_0201_0603Metric_Pad0.64x0.40mm_HandSolder
C2, C3: 10µF; C_0201_0603Metric_Pad0.64x0.40mm_HandSolder
D2: 1N4148WT; D_SOD-523
D3: LED; LED_0201_0603Metric_Pad0.64x0.40mm_HandSolder
H1: MountingHole_Pad; TestPoint_Pad_1.5x1.5mm
H2, H3, H4, H5, H6: MountingHole_Pad; TestPoint_Pad_D1.5mm
Q1, Q2: BSS138; SOT-23
R1, R2, R3, R4, R5, R6: 10K; R_0201_0603Metric_Pad0.64x0.40mm_HandSolder
R7: to determine; R_0201_0603Metric_Pad0.64x0.40mm_HandSolder
U1: VL53L0CXV0DH1; ST_VL53L1x
U3: LP5907MFX-2.8; SOT-23-5

Connections:
2.8V: C1.1, C2.1, Q1.1 (G), Q2.1 (G), R1.1, R2.1, R5.1, R6.1, R7.1, U1.1 (AVDDVCSEL), U1.11 (AVDD), U3.5 (OUT)
GND: C1.2, C2.2, C3.2, D3.1 (K), H2.1, U1.2 (AVSSVCSEL), U1.3 (GND), U1.4 (GND), U1.6 (GND), U1.12 (GND), U3.2 (GND)
GPIO: H5.1, R2.2, U1.7 (GPIO1)
unnamed: D2.2 (A), R1.2, U1.5 (XSHUT)
unnamed: D3.2 (A), R7.2
SCL: H4.1, Q1.2 (S), R3.2
SCL_3V: Q1.3 (D), R5.2, U1.10 (SCL)
SDA: H3.1, Q2.2 (S), R4.2
SDA_3V: Q2.3 (D), R6.2, U1.9 (SDA)
VCC: C3.1, H1.1, R3.1, R4.1, U3.1 (IN), U3.3 (EN)
XSHUT: D2.1 (K), H6.1

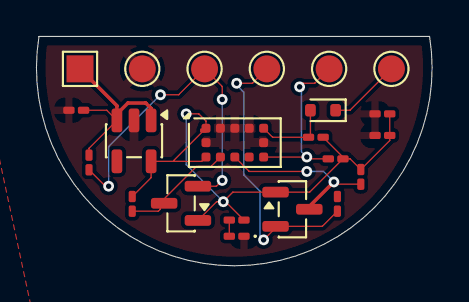
[picture p48: board PCB_microcontroller/PCB_sensor_V1/PCB_sensor.kicad_pcb from above]

Board: 2 copper layers, 22.0 x 12.7 mm, 22 parts (0 on the bottom side), 11 nets.
