willemet-remy/minidisk_automation/(commit log)

2026-01-09 Question about servo motors
2026-01-30 access hardware dvp files
    [Acrylic Tube.f3d, Bottom cap.f3d, Fitting_Bottom.f3d, Fitting_Top.f3d, Fitting_middle.f3d, Mariott bottle idea.step, Metal Tube.f3d, Metalic Tube 2.f3d]
2026-01-30 Work on prototype
2026-02-03 BOM creation
    [BOM_PCB_V4.csv, PCB_sensor.kicad_sch, Slimme_minidisk_BOM.xlsx]
2026-02-12 Development lit/cap for mindisk
    [Body3.stl, Body4.stl, Cap_bottom_V2.stl, Slimme_minidisk_BOM.xlsx, Top cap.stl, Top_Cap_V2_1.stl, Top_Cap_V2_2.stl, Top_Cap_V2_Suppport.stl]
2026-02-12 example added from github for multiple sensors
2026-02-13 Code V2 - not working
    [config.h, main.cpp]
2026-02-19 start Raspberrypi interface
2026-02-19 Printable caps
    [Cap.stl, Lit_Bottom_part.stl, Lit_Top_part.stl]
2026-03-01 steady flow algo
2026-03-02 Final version 3D parts
    [Cao_bottom_V3.stl, Cap_1.stl, Cap_2.stl, Cap_3.stl, Join_tube_V2.stl]
2026-03-03 Final version hardware
    [Body1.stl, Body2.stl, Body3.stl, Cao_bottom_V3.stl, Join_tube_V2.stl]
2026-03-05 new pieces top and joint
    [Body4.stl, Join_tube_V2.stl]
2026-03-08 2nd part case
    [Body3.stl]
2026-03-09 Cap minidisk tpu
    [Cap_join.stl]
2026-03-09 case 2nd
    [Body1.stl, Body3.stl]
2026-03-10 cap V2
    [Cap_join_2.stl]
2026-03-10 cap V3
    [Cap_join_2.stl]
2026-03-11 cap sensor
    [Test1.stl, Test2.stl]
2026-03-11 cap sensor V2
    [Body5.stl, Body6.stl]
2026-03-13 Modif cap
    [Body5.stl, Body6.stl]
2026-03-13 Creation arduino version
2026-03-13 first version arduino reading
2026-03-13 Adruino V2
    [minidisk_Plot_A_20260313_101214.csv, minidisk_Plot_A_20260313_101233.csv]
2026-03-13 Structure folder
    [minidisk_Plot_A_20260313_101214.csv, minidisk_Plot_A_20260313_101233.csv]
2026-03-13 modif interface final
    [minidisk_Plot_A_20260313_101214.csv, minidisk_Plot_A_20260313_101233.csv]
2026-07-27 ESP32 idea software
2026-07-27 1st test, connection ok, data NA
    [Test_20260727_232445.csv]
2026-08-12 dvp esp32 code
    [Body1.stl, Body5.stl, Body6.stl, CapV2_bouchon.stl, Test_20260728_114806.csv, VL53.f3d, VL53.stl, VL53_sketch.dxf]
2026-08-27 modif software
    [20260817_print_bambu.gcode.3mf, Body1.stl, Body5.stl, Body6.stl]
2026-09-10 Final 3D case parts
    [Body1.stl, Body5.stl, Body6.stl]
2026-09-15 fusion 360 schematic view
    [18650 3.7V Battery Box Case with On Off Switch.STEP, 2772T93_NO THREADS_Straight Plastic On-Off Valve.stl, AH14629-A.stp, Acrylic Tube.stl, Acrylic_Tube_small.stl, Cap_bottom.stl, Esp32-C3_mini.STEP, Joint_tubes.stl]
2026-09-15 folder structure update
    [18650 3.7V Battery Box Case with On Off Switch.STEP, 20260817_print_bambu.gcode.3mf, 2772T93_NO THREADS_Straight Plastic On-Off Valve.stl, AH14629-A.stp, Acrylic Tube.f3d, Acrylic Tube.stl, Acrylic_Tube_small.stl, Body1.stl]
2026-10-27 update reamde
    [Body5.stl, Body6.stl, Schematic view.kicad_pcb, Schematic view.kicad_sch, Test_20260727_232445.csv, Test_20260728_114806.csv, Test_20260823_190513.csv, Test_20260827_115555.csv]
2026-10-27 Readme add licence, schematic view
2026-11-09 modif readme
    [18650 3.7V Battery Box Case with On Off Switch.STEP, 2772T93_NO THREADS_Straight Plastic On-Off Valve.stl, AH14629-A.stp, Acrylic Tube.stl, Acrylic_Tube_small.stl, Body5.stl, Body6.stl, Cap_top_body1.stl]
