willemet-remy/minidisk_automation/(notices)

Notices in the files:
README.md:
License: MIT
