willemet-remy/minidisk_automation/Figures/IMG_9299.jpg

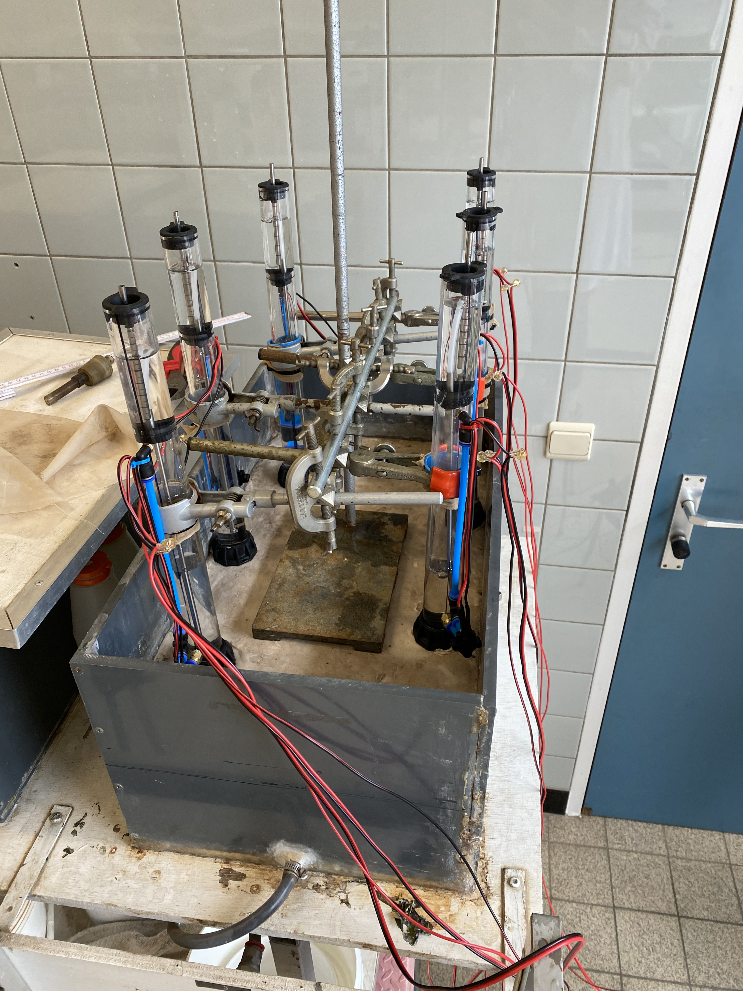
Figures/IMG_9299.jpg
