willemet-remy/minidisk_automation/Figures/IMG_9342.jpg

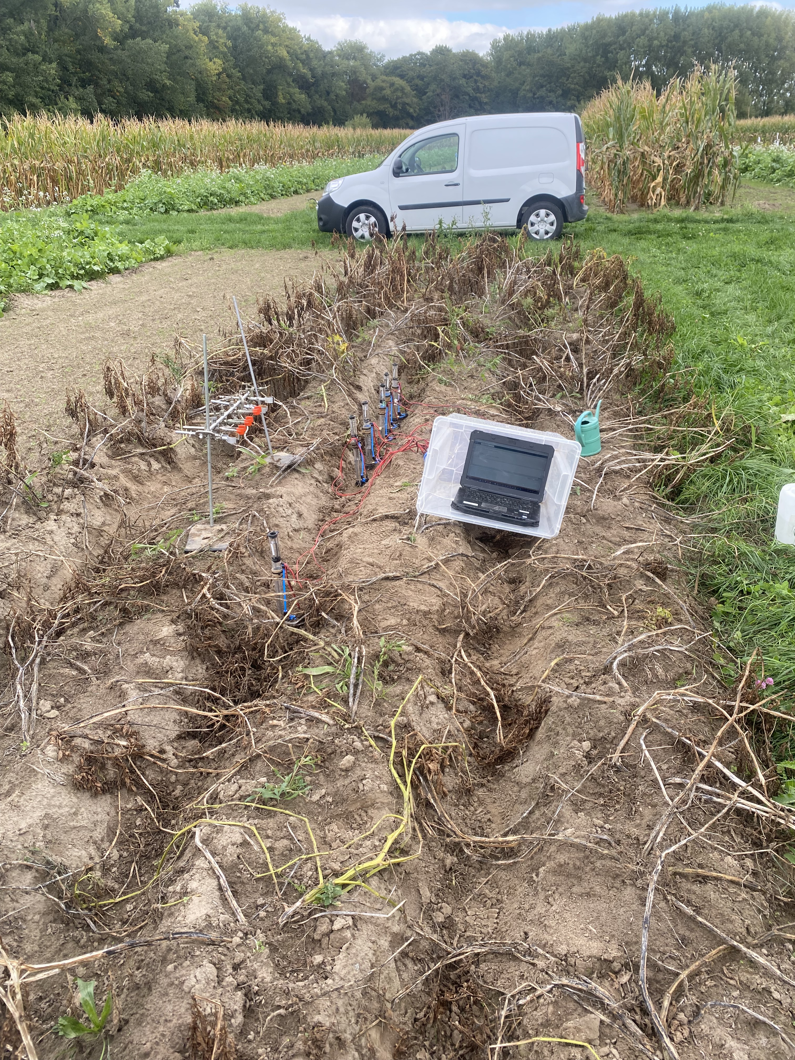
Figures/IMG_9342.jpg
