willemet-remy/minidisk_automation/Figures/IMG_9348.jpg

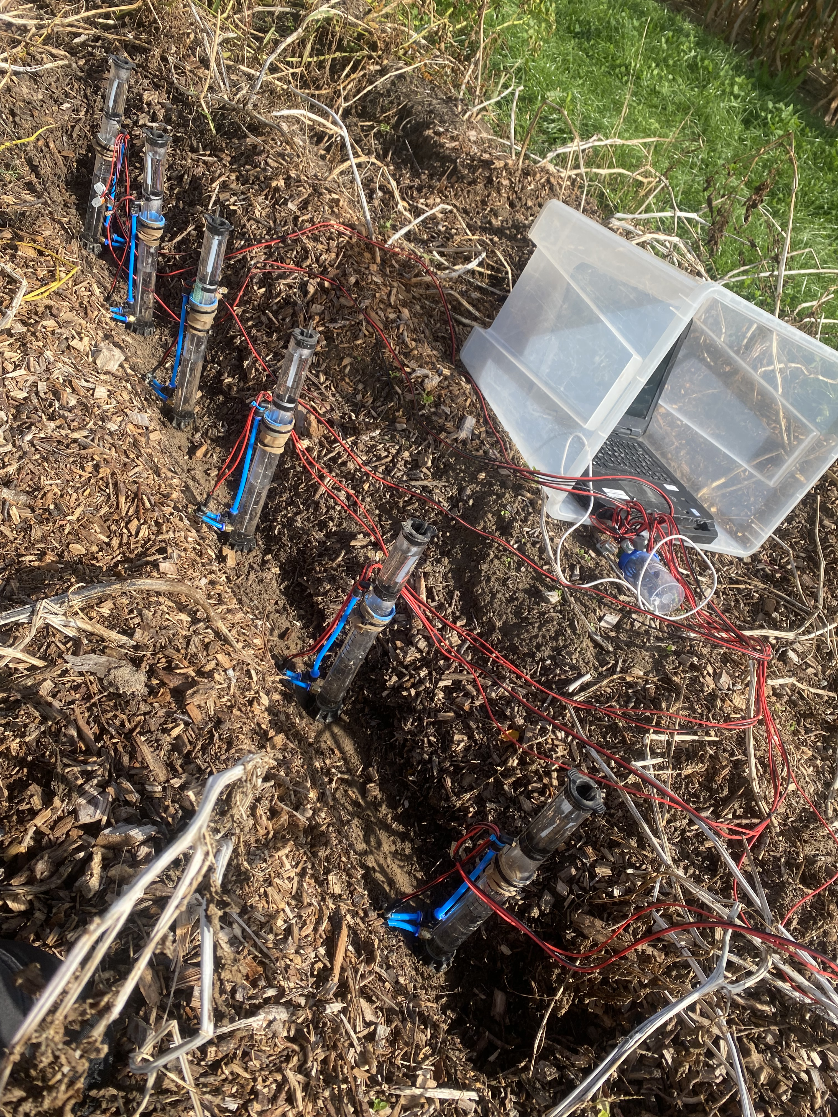
Figures/IMG_9348.jpg
