willemet-remy/minidisk_automation/Figures/IMG_9349.jpg

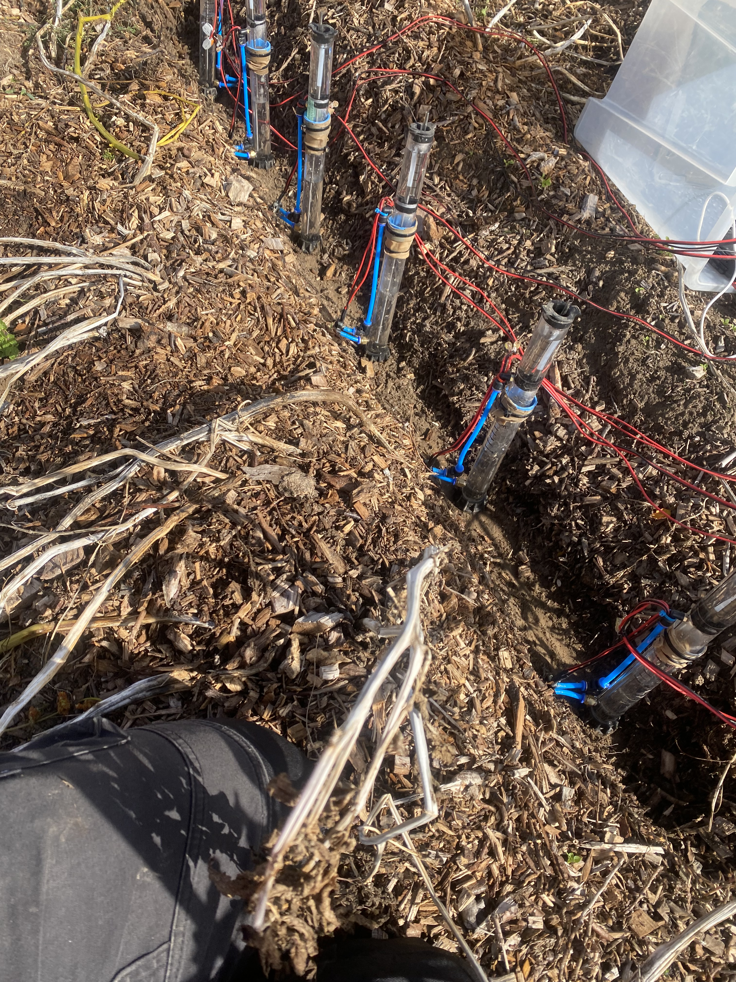
Figures/IMG_9349.jpg
