willemet-remy/minidisk_automation/Figures/IMG_9350.jpg

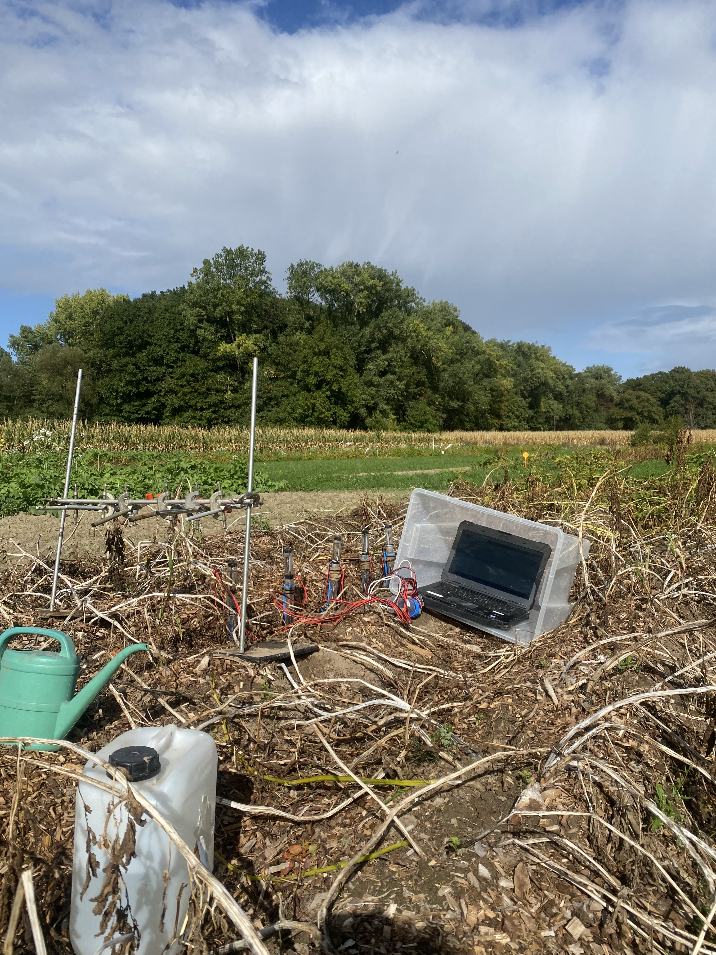
Figures/IMG_9350.jpg
