willemet-remy/minidisk_automation/Figures/IMG_9351.jpg

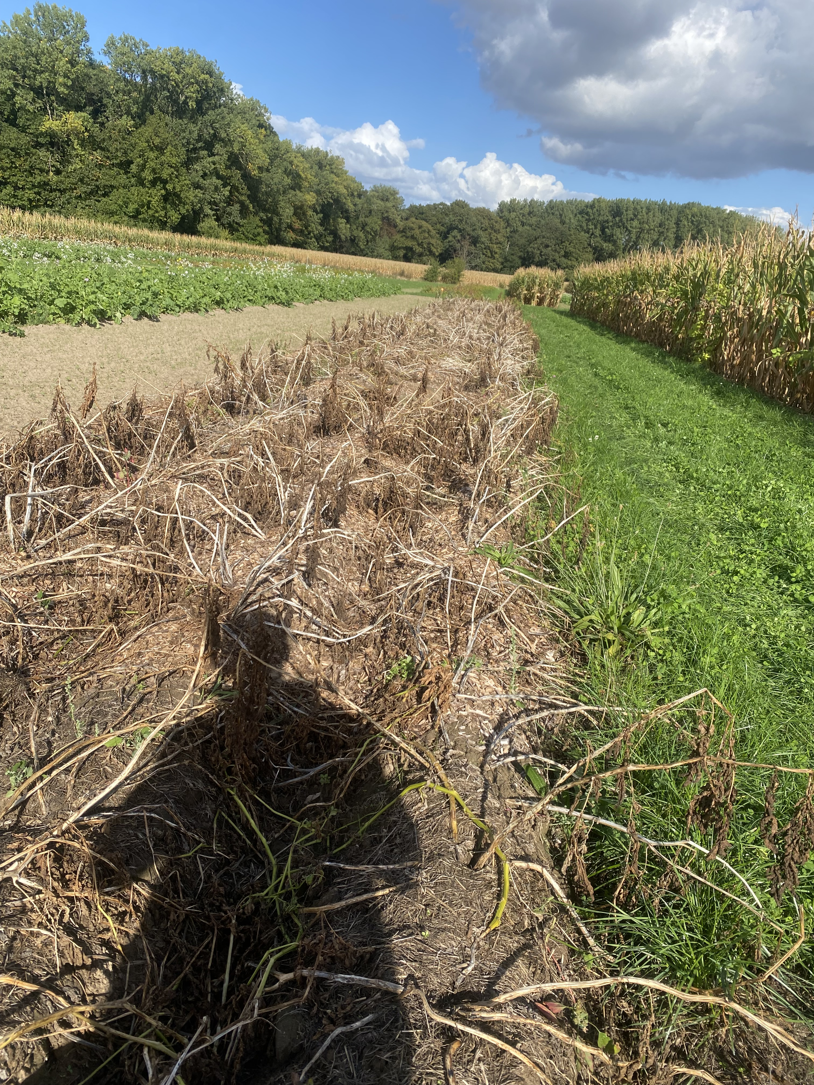
Figures/IMG_9351.jpg
