willemet-remy/minidisk_automation/Figures/IMG_9369.jpg

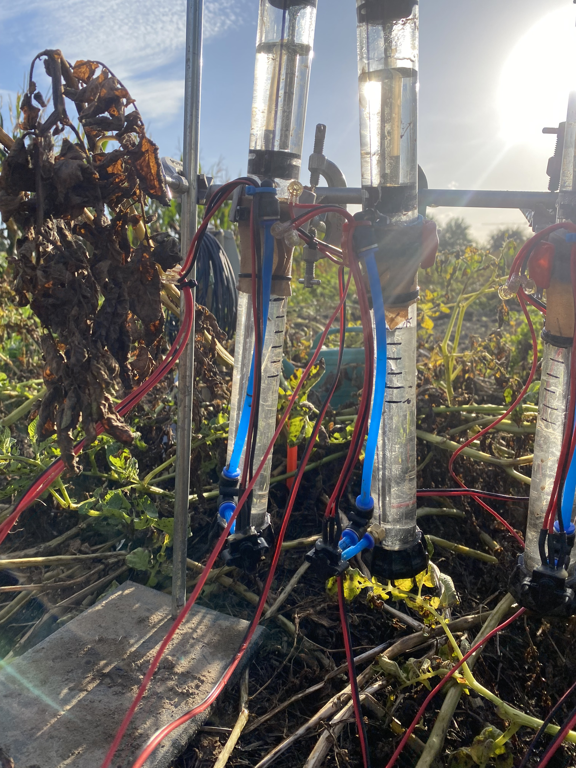
Figures/IMG_9369.jpg
