willemet-remy/minidisk_automation/Figures/IMG_9371.jpg

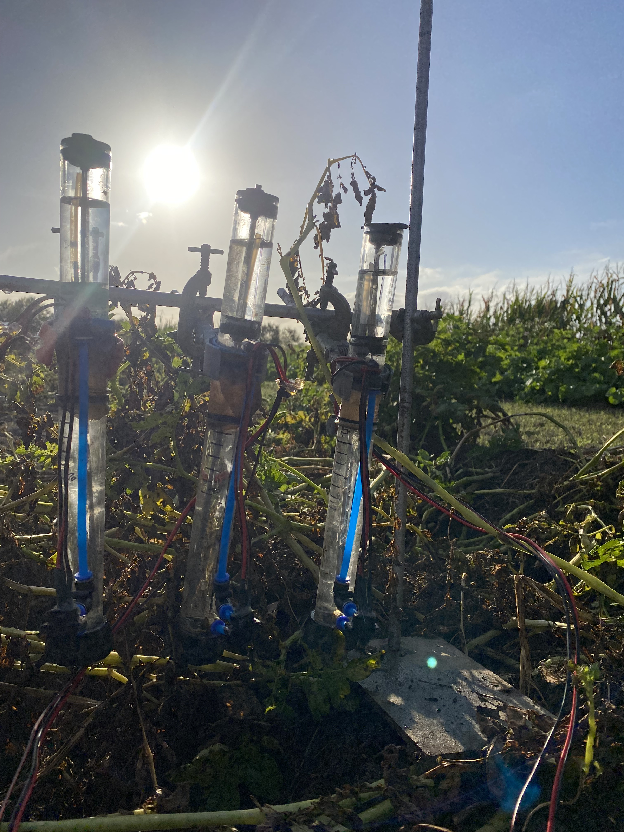
Figures/IMG_9371.jpg
